Endymion1236/robothumanoide/apercu-bras/animation_bras.gif

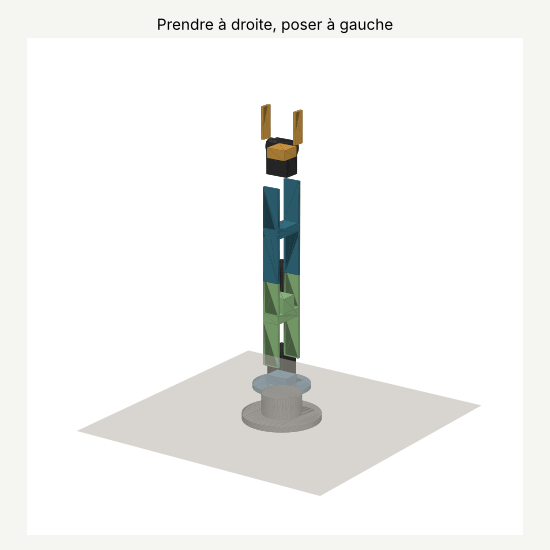
apercu-bras/animation_bras.gif
