Endymion1236/robothumanoide/apercu-bras/apercu_bras_complet.png

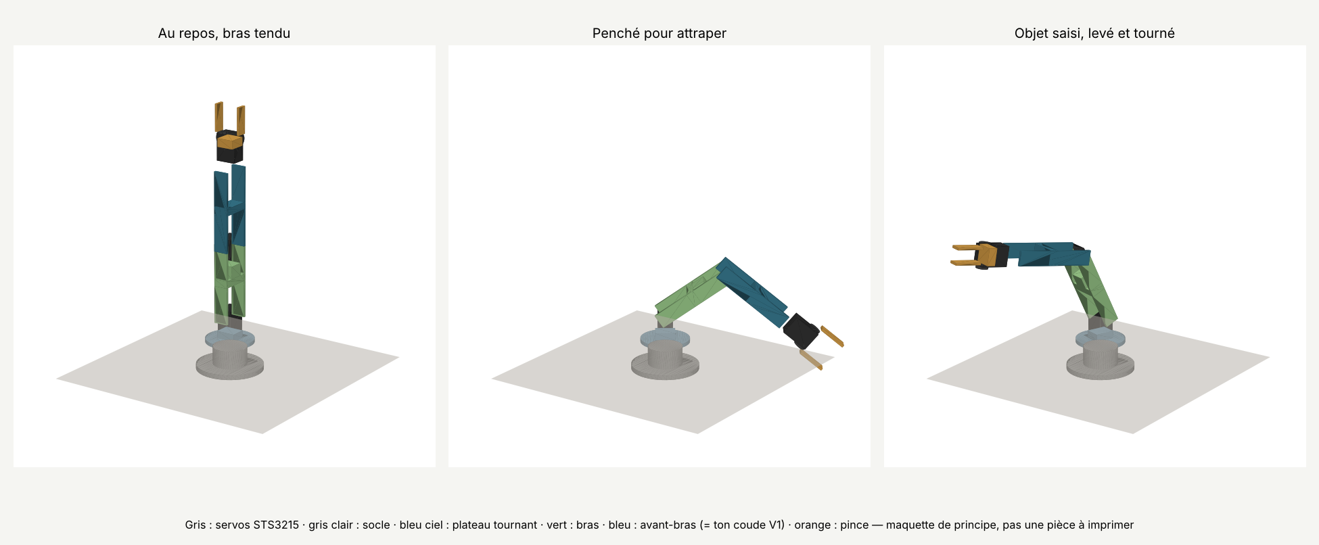
apercu-bras/apercu_bras_complet.png
