Endymion1236/robothumanoide/apercu-bras/etapes_suivantes.png

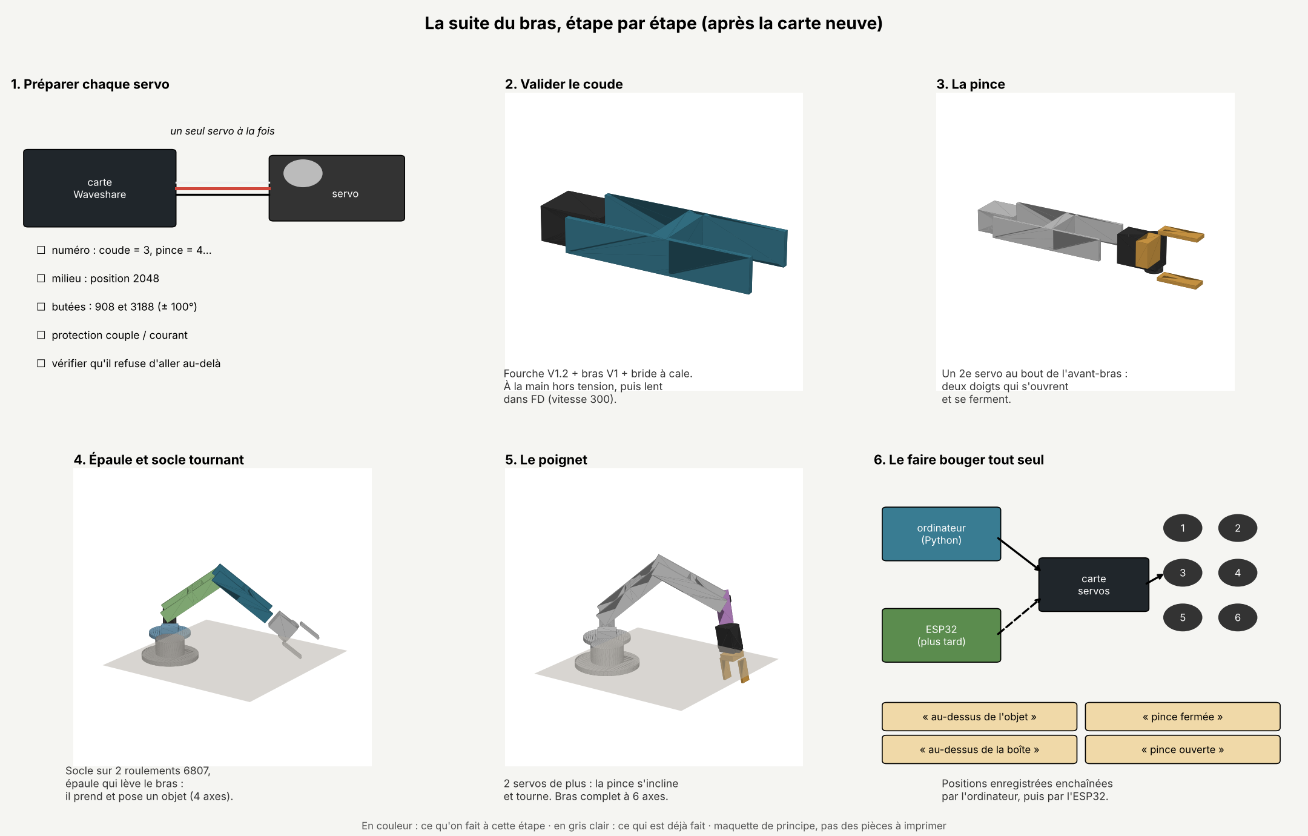
apercu-bras/etapes_suivantes.png
