Endymion1236/robothumanoide/apercu_V4.png

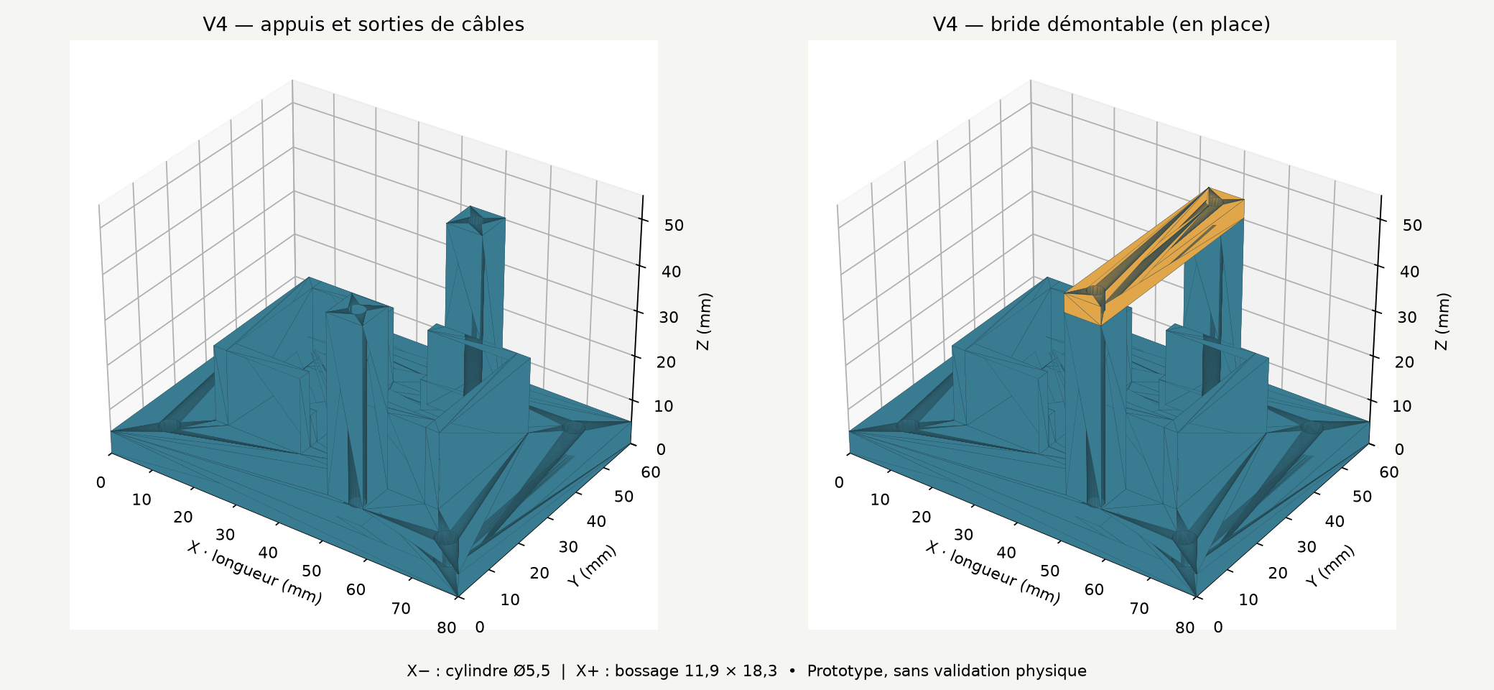
apercu_V4.png
