Endymion1236/robothumanoide/coude-sts3215/outputs/bras_v1/apercu_coude_sur_bras_V1.png

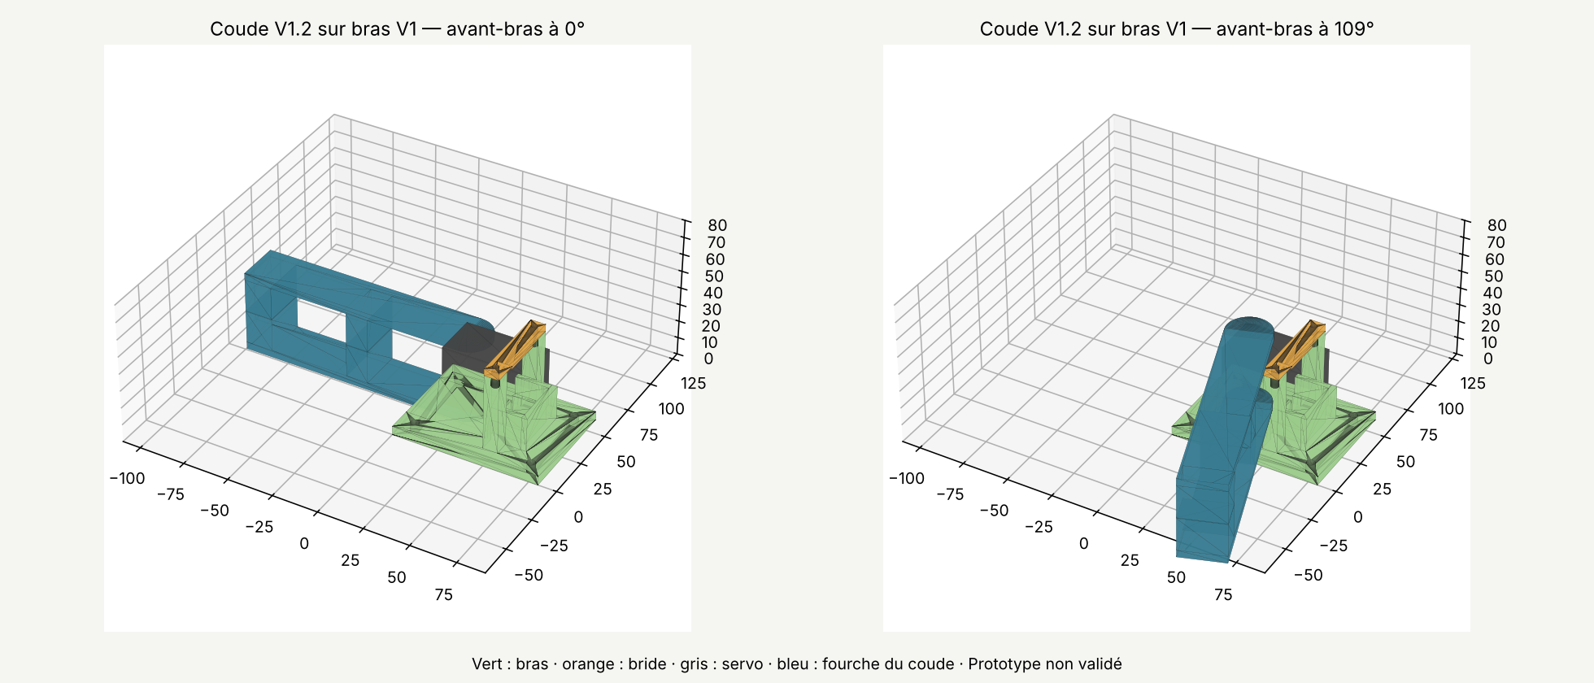
coude-sts3215/outputs/bras_v1/apercu_coude_sur_bras_V1.png
