Endymion1236/robothumanoide/coude-sts3215/outputs/coude_v1_2/apercu_coude_V1_2.png

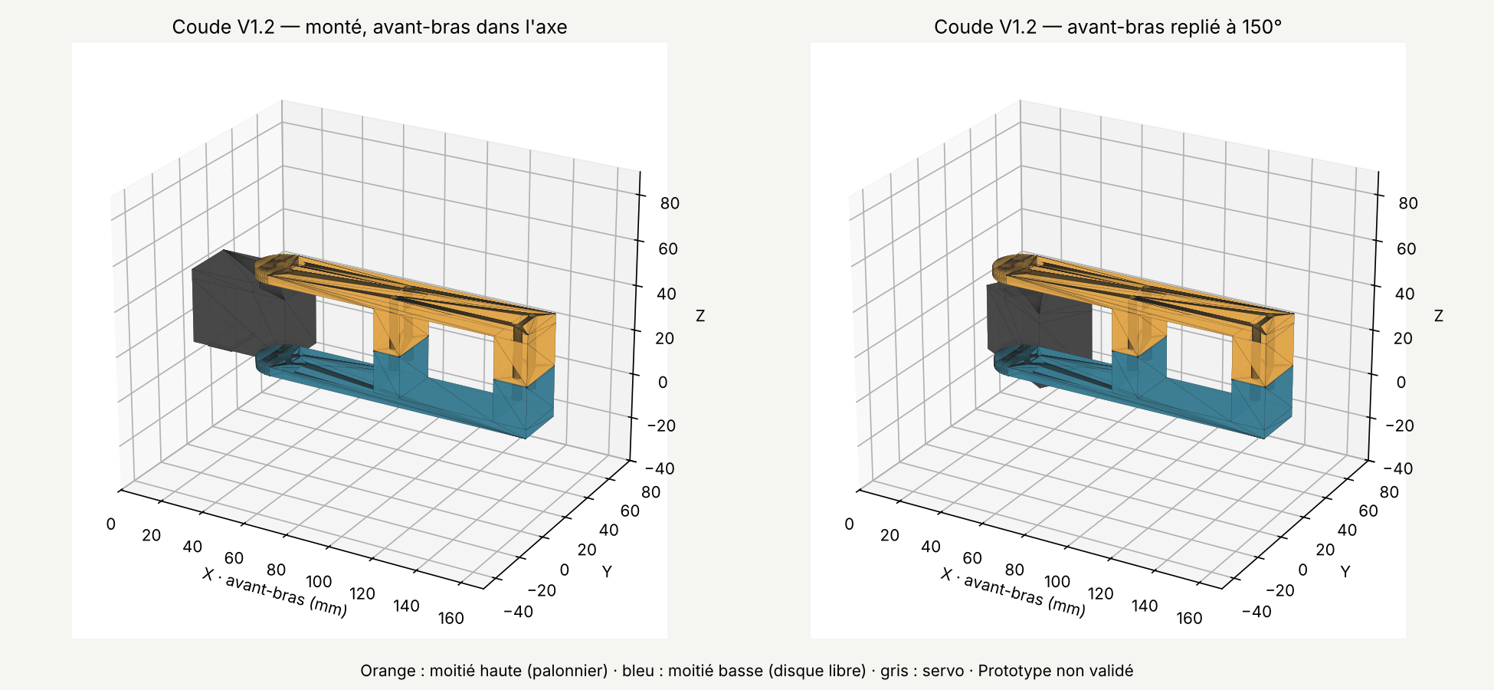
coude-sts3215/outputs/coude_v1_2/apercu_coude_V1_2.png
