Endymion1236/robothumanoide/pince/sortie/animation_pince.gif

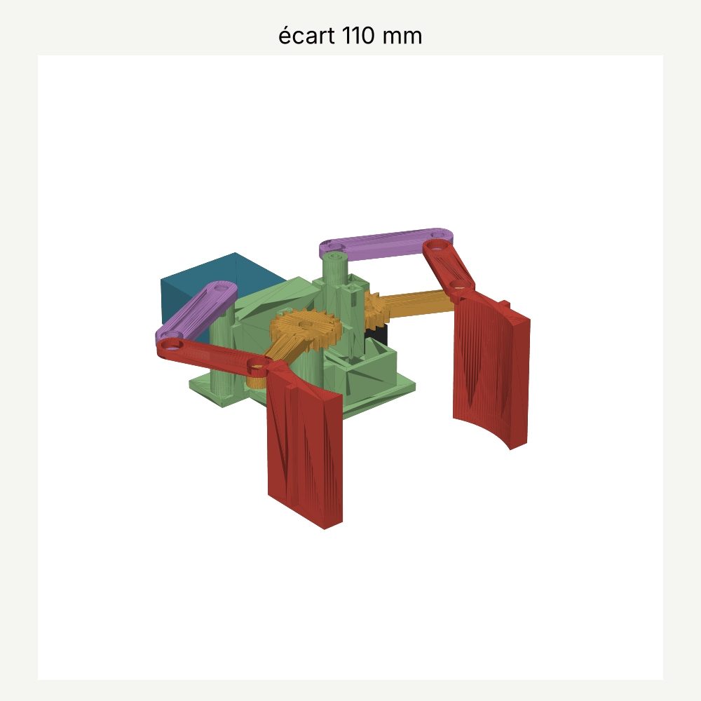
pince/sortie/animation_pince.gif
