Endymion1236/robothumanoide/pince/sortie/apercu_pince.png

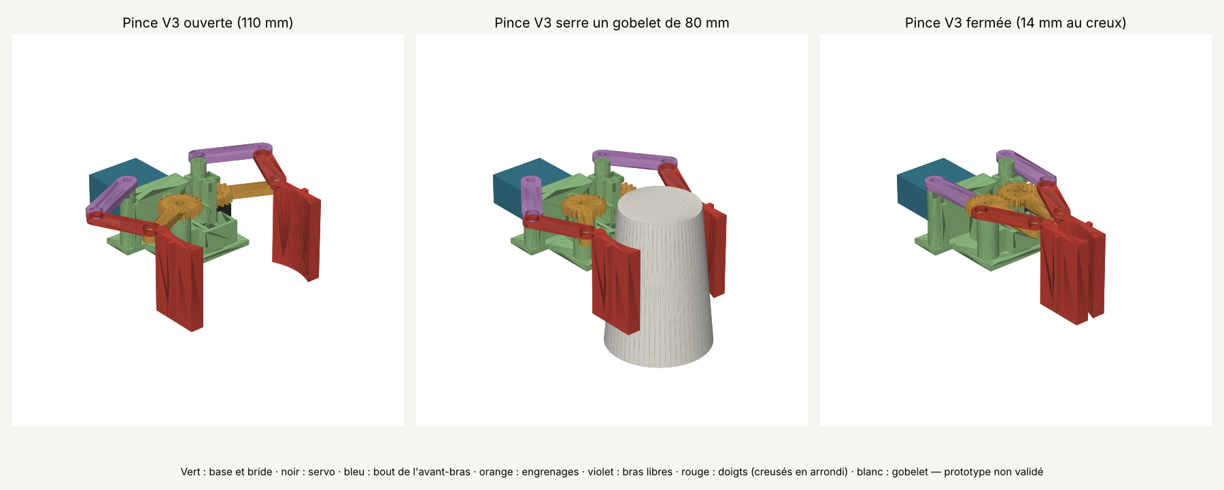
pince/sortie/apercu_pince.png
