Endymion1236/robothumanoide/pince/sortie/vue_dessus_montee.png

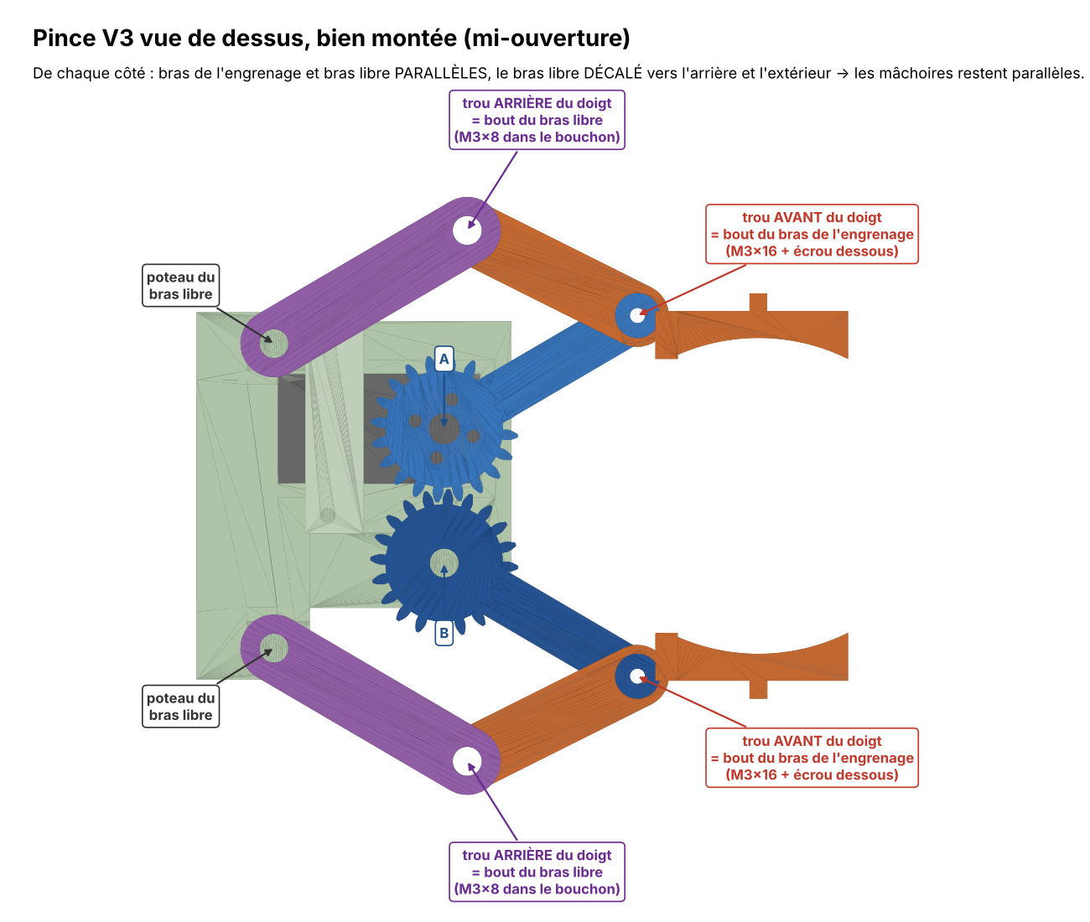
pince/sortie/vue_dessus_montee.png
