Endymion1236/robothumanoide/apercu-bras/maquette_bras_complet.stl

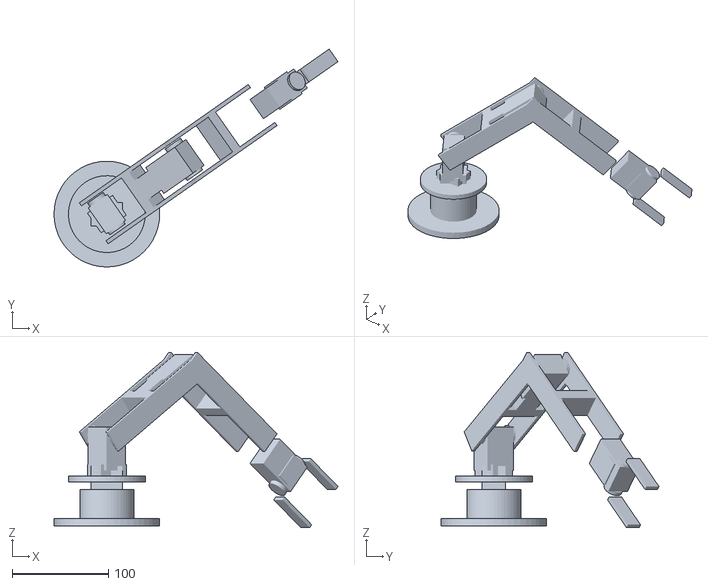
[picture p10: CAD file, 2026-11-07]
apercu-bras/maquette_bras_complet.stl
295.5 x 226.8 x 182.5
