Endymion1236/robothumanoide/berceau-sts3215/outputs/servo_cradle_v4_1/berceau_V4_1_TEST.stl

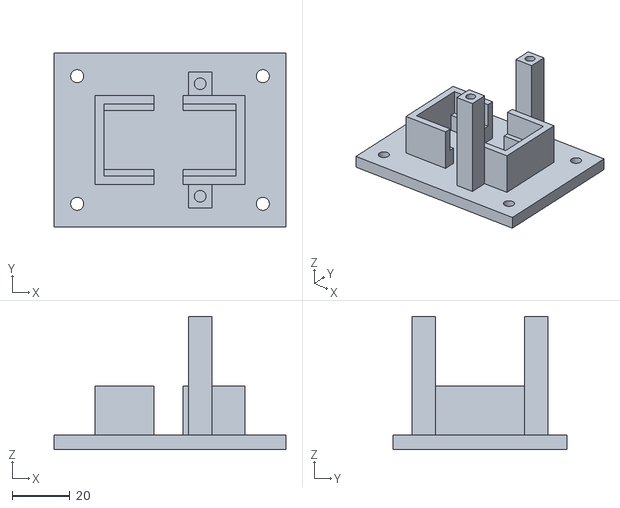
[picture p11: CAD file, 2026-11-07]
berceau-sts3215/outputs/servo_cradle_v4_1/berceau_V4_1_TEST.stl
80.0 x 60.0 x 45.9
