Endymion1236/robothumanoide/berceau_V4_TEST.stl

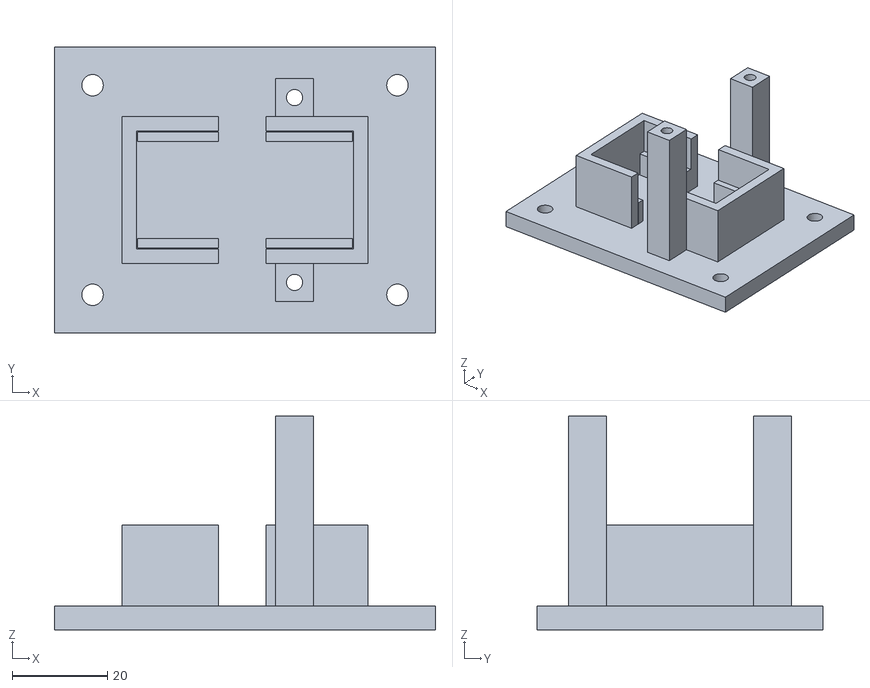
[picture p12: CAD file, 2026-11-07]
berceau_V4_TEST.stl
80.0 x 60.0 x 44.9
