Endymion1236/robothumanoide/coude-sts3215/outputs/bras_v1/bride_bras_V1_2_TEST.stl

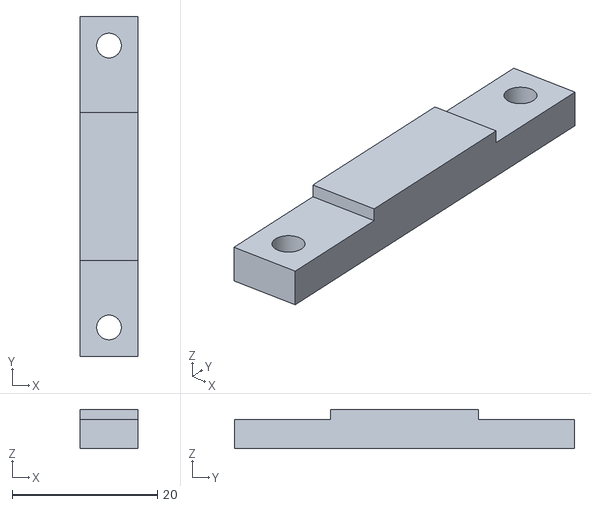
[picture p13: CAD file, 2026-11-08]
coude-sts3215/outputs/bras_v1/bride_bras_V1_2_TEST.stl
8.00 x 46.8 x 5.40
