Endymion1236/robothumanoide/coude-sts3215/outputs/coude_v1_2/fourche_basse_V1_2.stl

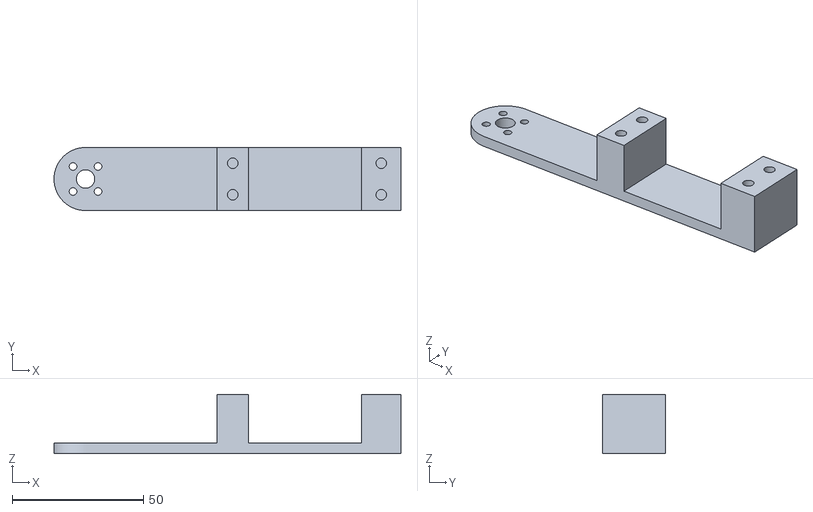
[picture p14: CAD file, 2026-11-08]
coude-sts3215/outputs/coude_v1_2/fourche_basse_V1_2.stl
132.0 x 24.0 x 22.5
