Endymion1236/robothumanoide/pince/sortie/pince_bras_libre_+Y.stl

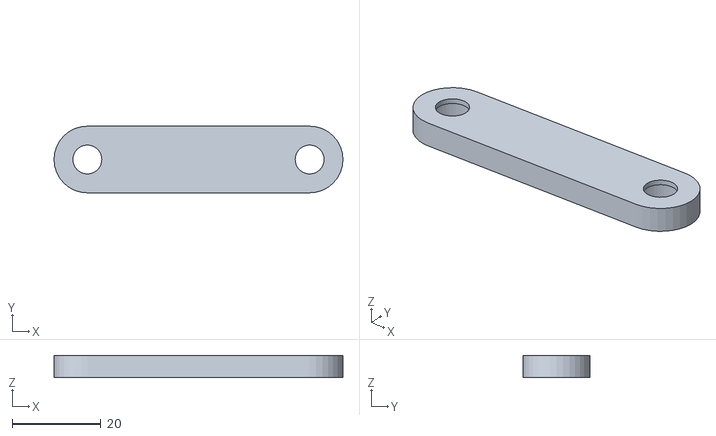
[picture p15: CAD file, 2026-11-14]
pince/sortie/pince_bras_libre_+Y.stl
65.0 x 15.0 x 5.00
