Endymion1236/robothumanoide/coude-sts3215/outputs/bras_v1/bras_V1_TEST.stl

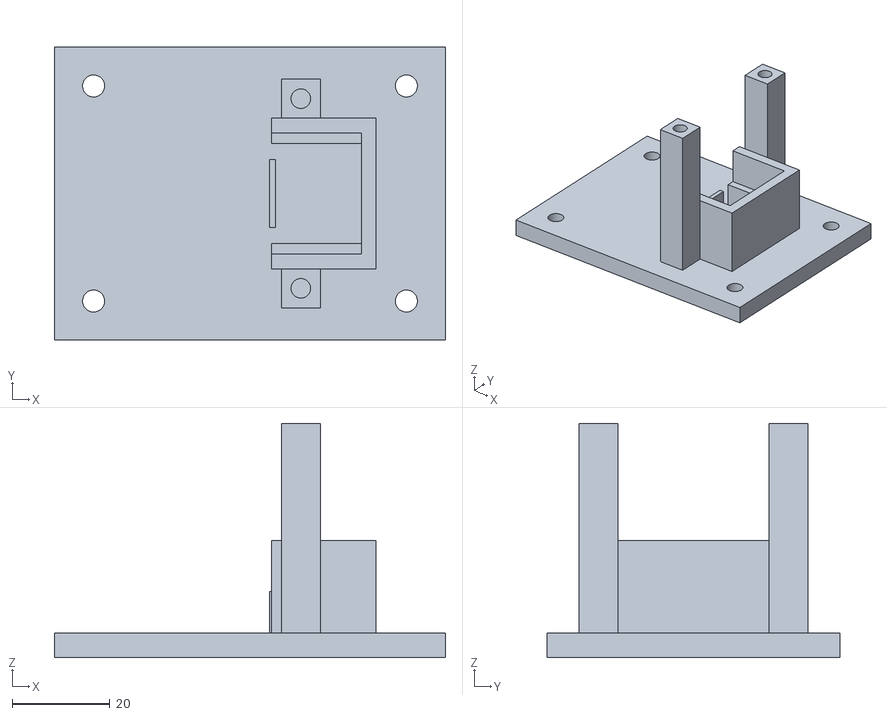
[picture p16: CAD file, 2026-11-07]
coude-sts3215/outputs/bras_v1/bras_V1_TEST.stl
80.0 x 60.0 x 47.9
