Endymion1236/robothumanoide/pince/sortie/pince_base.stl

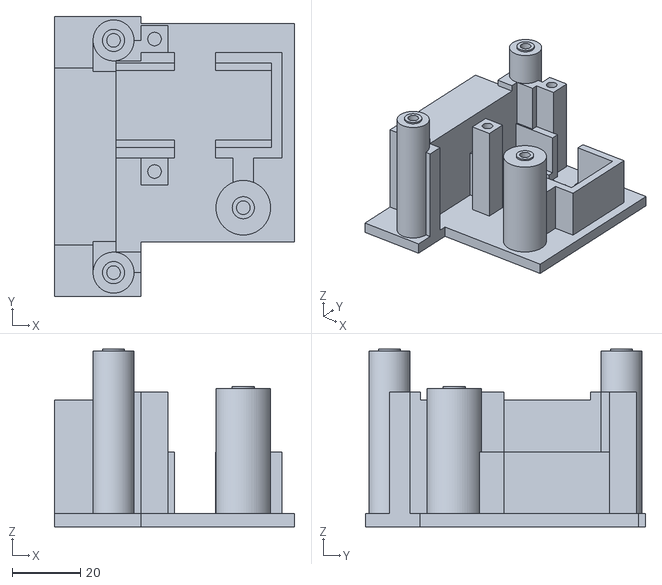
[picture p17: CAD file, 2026-11-14]
pince/sortie/pince_base.stl
70.3 x 82.0 x 52.1
