Endymion1236/robothumanoide/pince/sortie/pince_doigt_+Y.stl

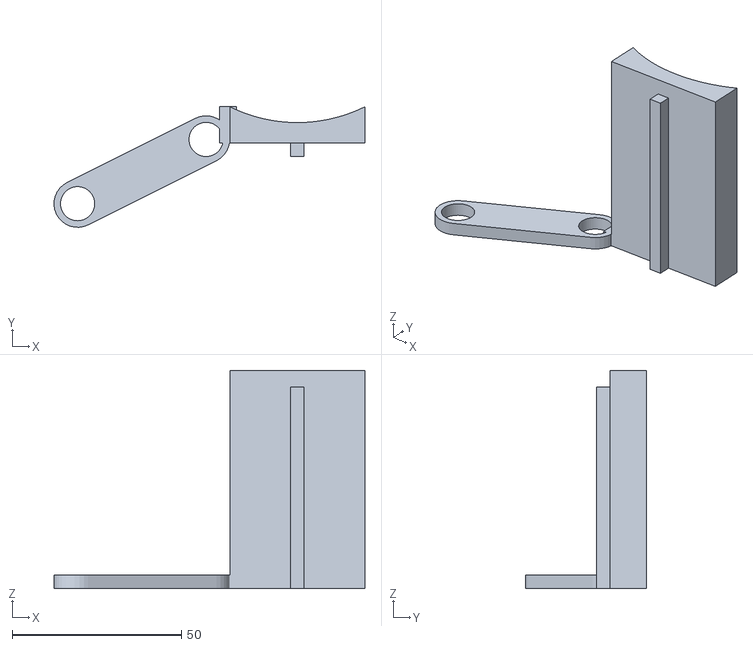
[picture p18: CAD file, 2026-11-14]
pince/sortie/pince_doigt_+Y.stl
92.0 x 35.7 x 64.6
