Endymion1236/robothumanoide/pince/sortie/pince_engrenage_A_vis6mm.stl

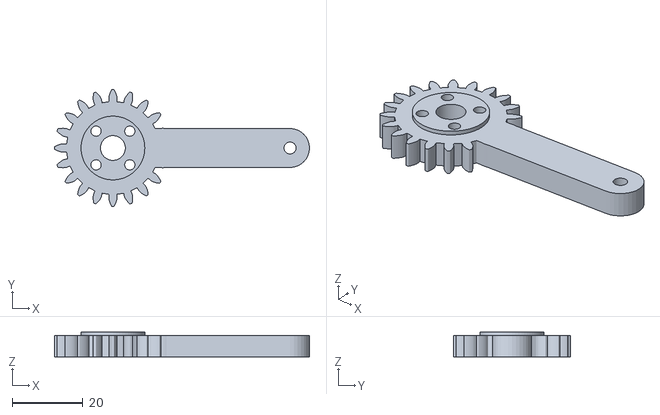
[picture p19: CAD file, 2026-11-14]
pince/sortie/pince_engrenage_A_vis6mm.stl
72.0 x 33.0 x 7.00
