Endymion1236/robothumanoide/pince/sortie/pince_engrenage_A.stl

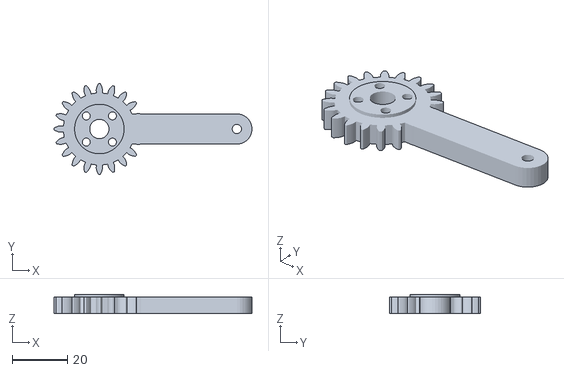
[picture p20: CAD file, 2026-11-14]
pince/sortie/pince_engrenage_A.stl
72.0 x 33.0 x 7.00
