Endymion1236/robothumanoide/pince/sortie/pince_engrenage_B.stl

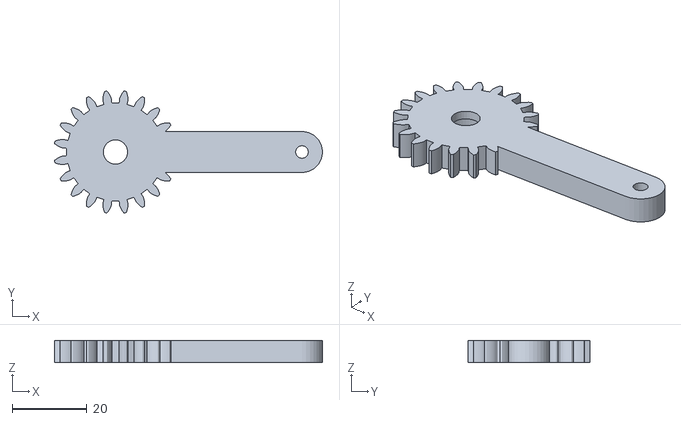
[picture p21: CAD file, 2026-11-14]
pince/sortie/pince_engrenage_B.stl
71.8 x 32.7 x 6.00
