Endymion1236/robothumanoide/pince/sortie/pince_doigt_+Y_insert.stl

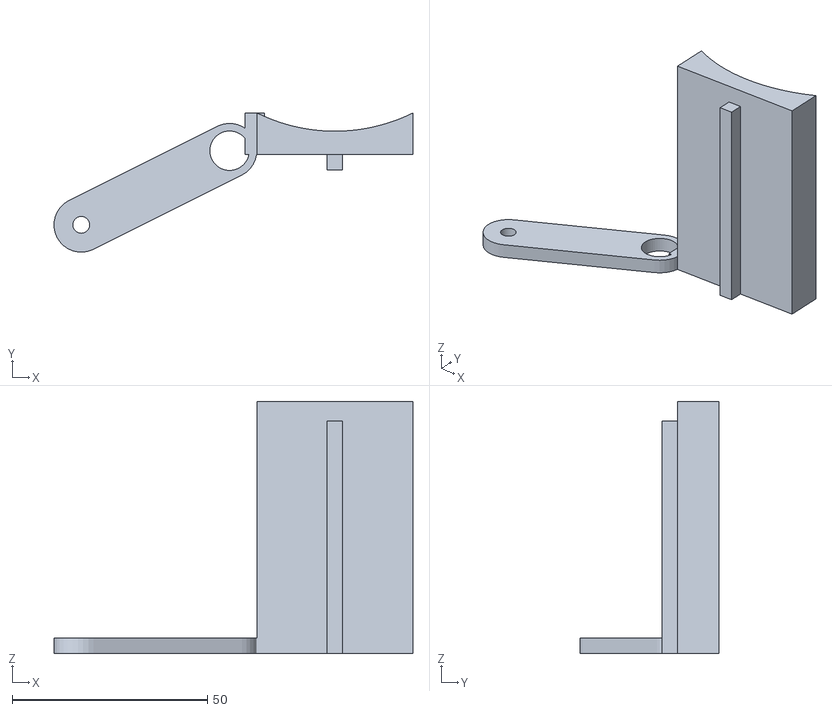
[picture p22: CAD file, 2026-11-14]
pince/sortie/pince_doigt_+Y_insert.stl
92.0 x 35.7 x 64.6
