Endymion1236/robothumanoide/pince/sortie/pince_bride.stl

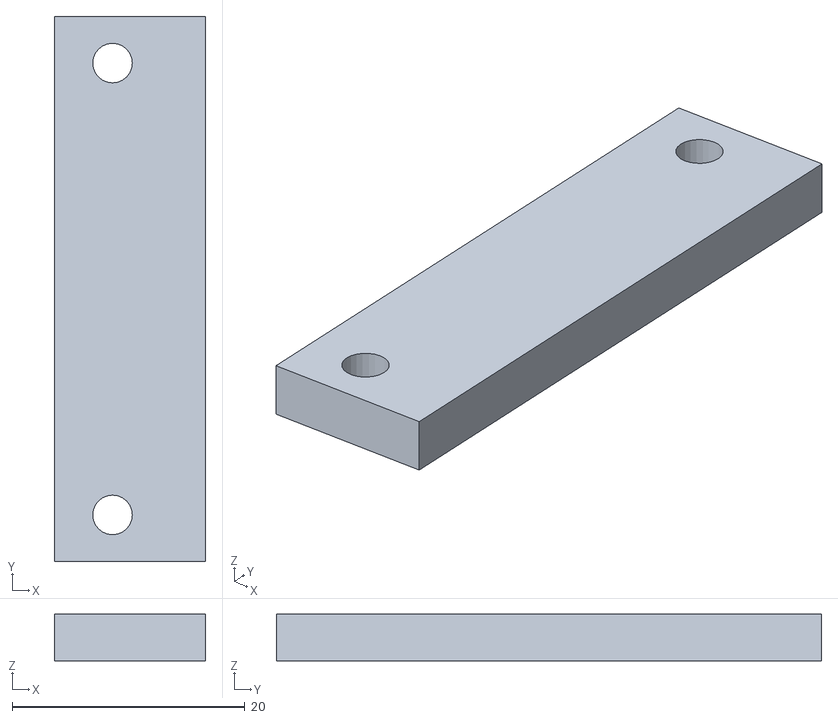
[picture p23: CAD file, 2026-11-14]
pince/sortie/pince_bride.stl
13.0 x 46.8 x 4.00
