Endymion1236/robothumanoide/pince/sortie/pince_bouchon_doigt_insert.stl

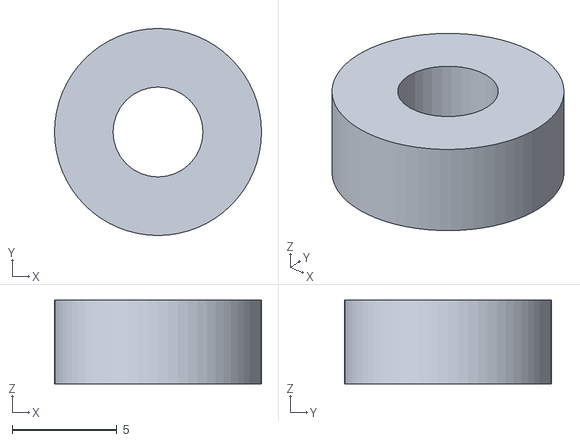
[picture p24: CAD file, 2026-11-14]
pince/sortie/pince_bouchon_doigt_insert.stl
9.90 x 9.90 x 4.00
