Endymion1236/robothumanoide/(list of files, cad)

Other CAD files:
coude-sts3215/outputs/coude_v1_2/fourche_haute_V1_2.stl
pince/sortie/pince_engrenage_A_vis5mm.stl
pince/sortie/pince_engrenage_A_vis4mm.stl
pince/sortie/pince_bouchon_doigt.stl
coude-sts3215/outputs/coude_v1/fourche_basse_V1.stl
coude-sts3215/outputs/coude_v1/fourche_haute_V1.stl
pince/sortie/pince_bras_libre_-Y.stl
pince/sortie/pince_doigt_-Y.stl
pince/sortie/pince_doigt_-Y_insert.stl
