Endymion1236/robothumanoide/pince/sortie/plan_montage_00.png

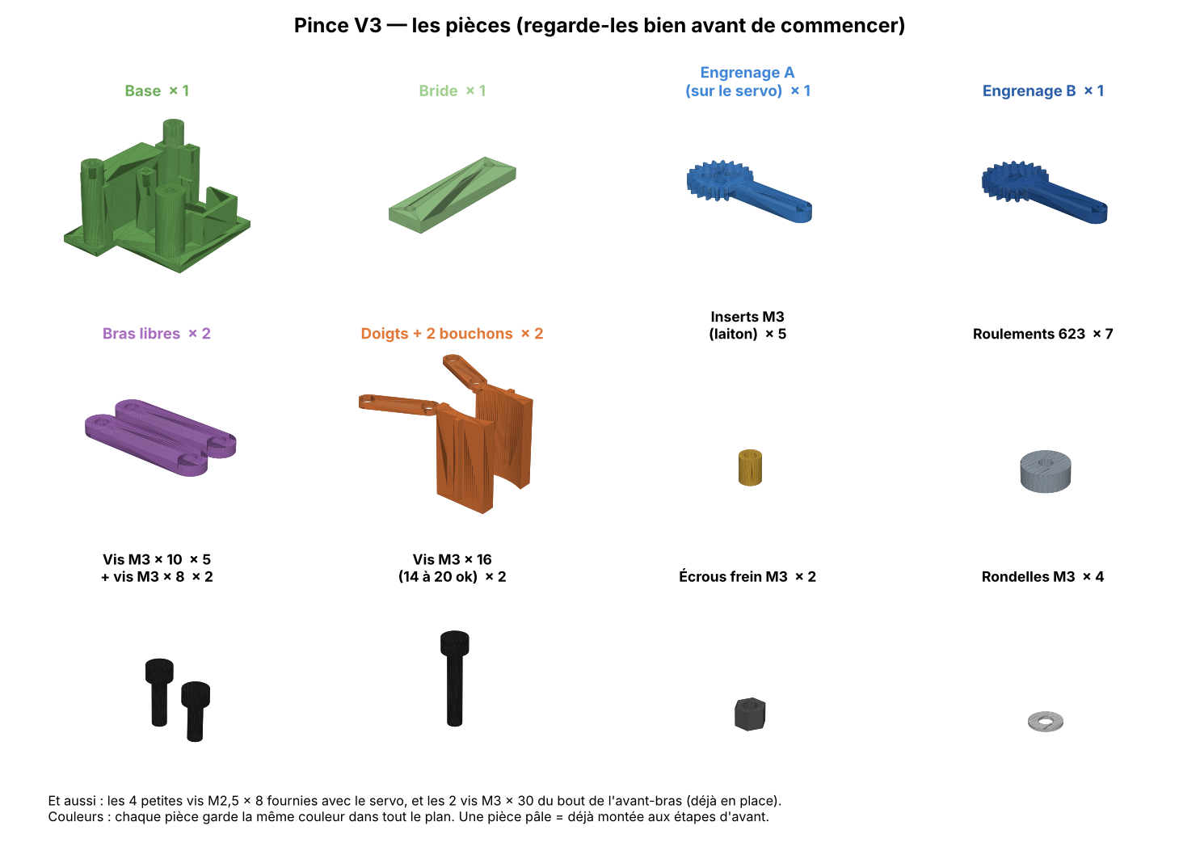
pince/sortie/plan_montage_00.png
