Endymion1236/robothumanoide/pince/sortie/plan_montage_01.png

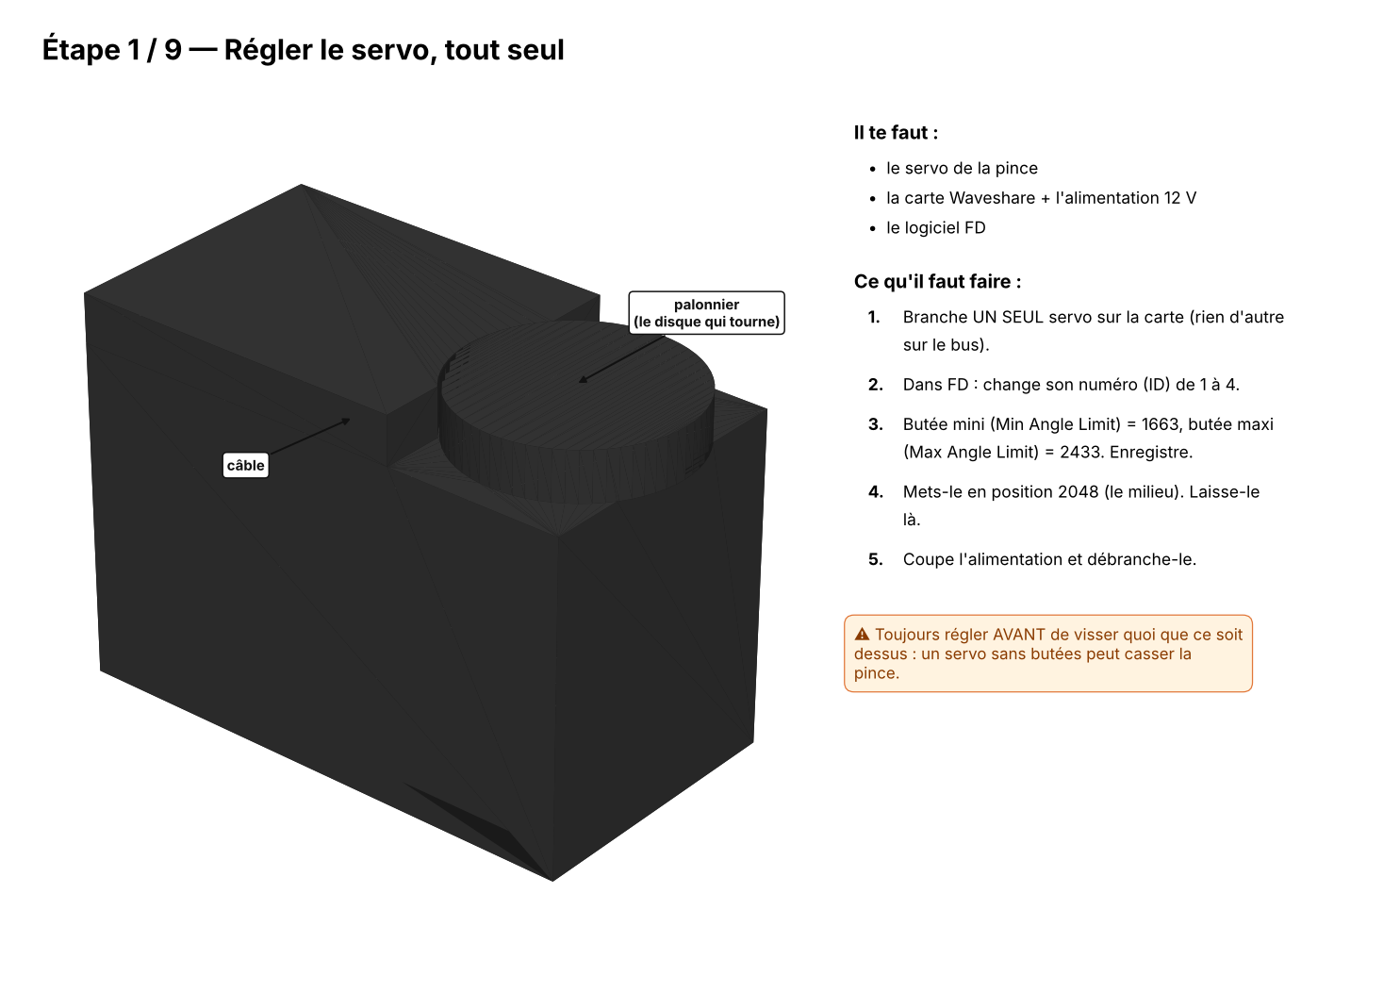
pince/sortie/plan_montage_01.png
