Endymion1236/robothumanoide/pince/sortie/plan_montage_02.png

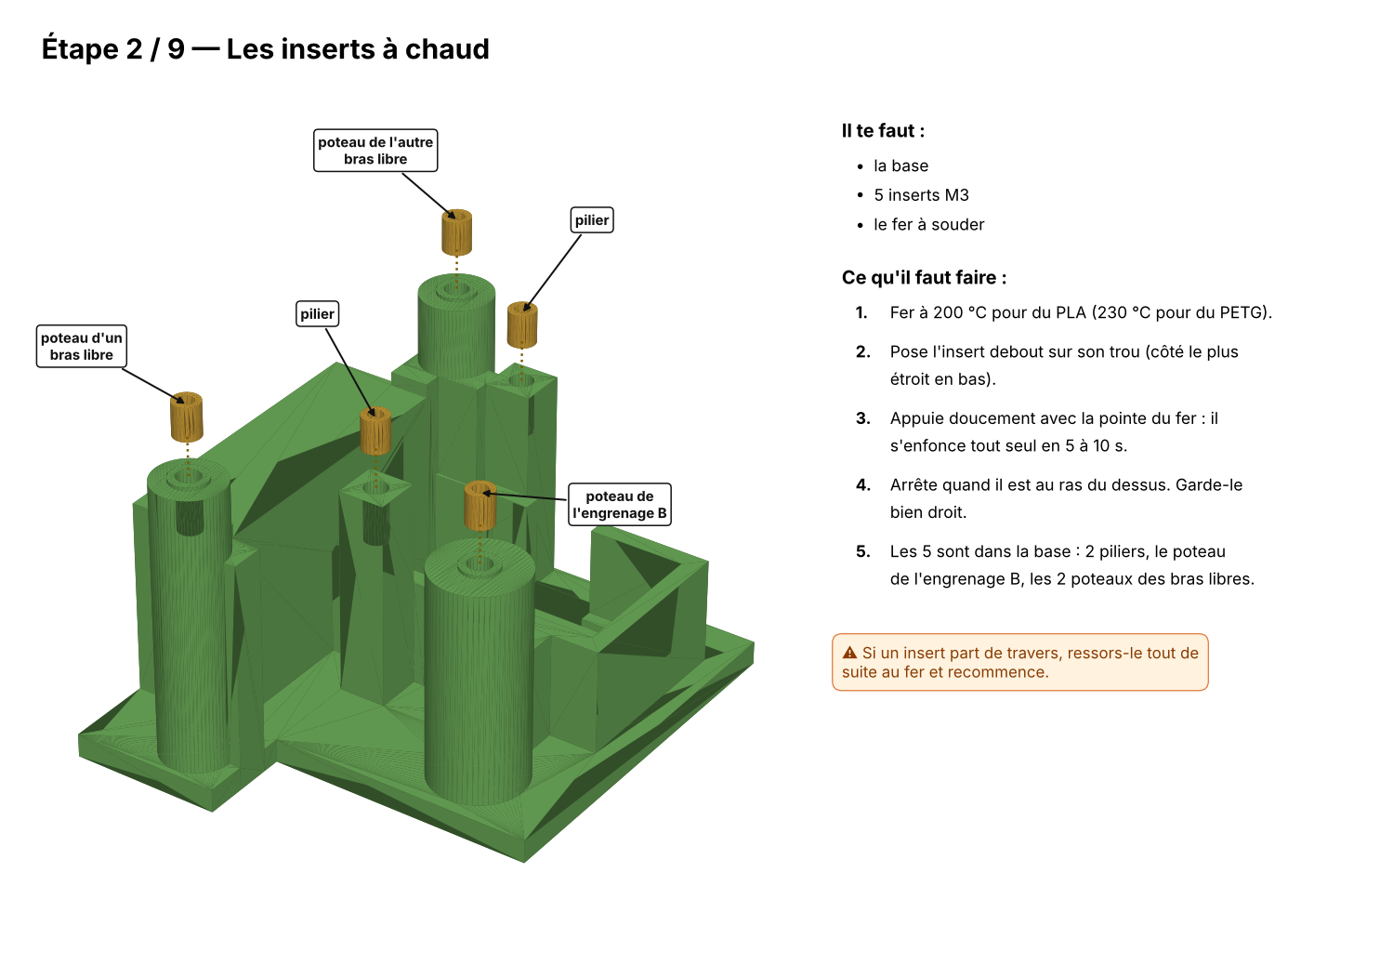
pince/sortie/plan_montage_02.png
