Endymion1236/robothumanoide/pince/sortie/plan_montage_03.png

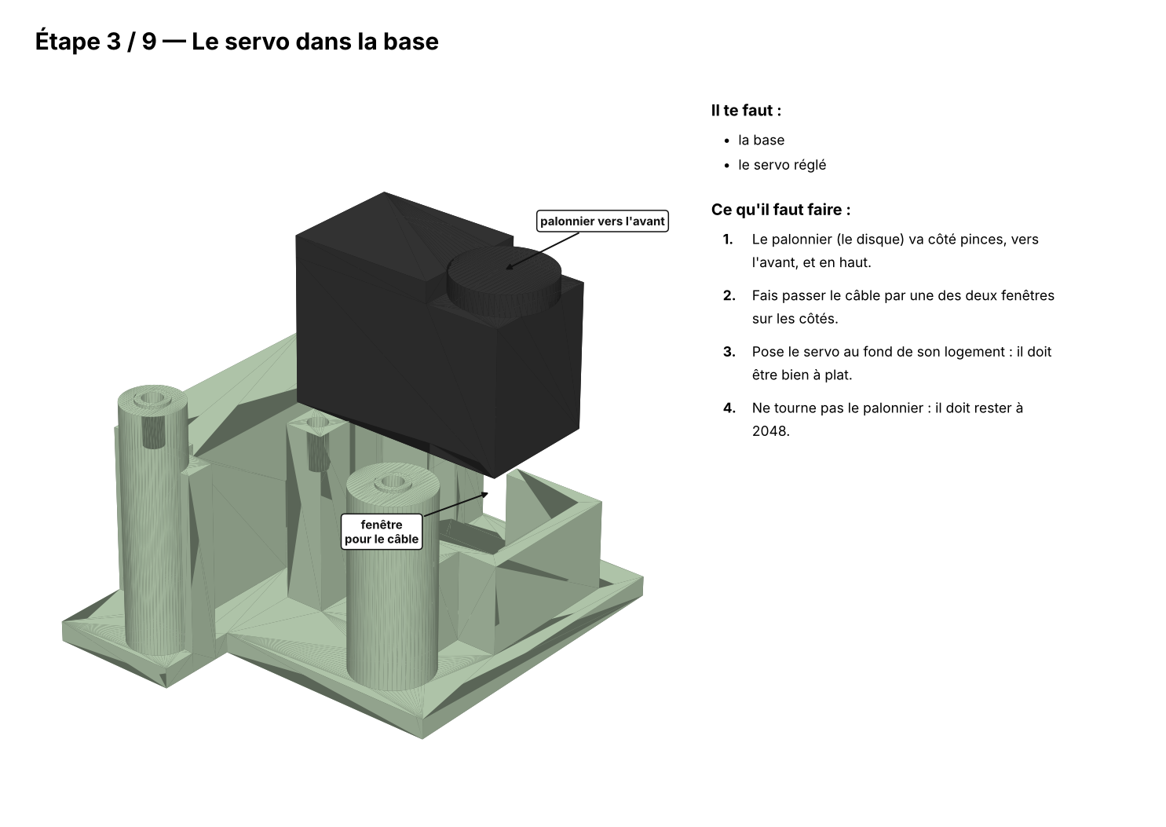
pince/sortie/plan_montage_03.png
