Endymion1236/robothumanoide/pince/sortie/plan_montage_04.png

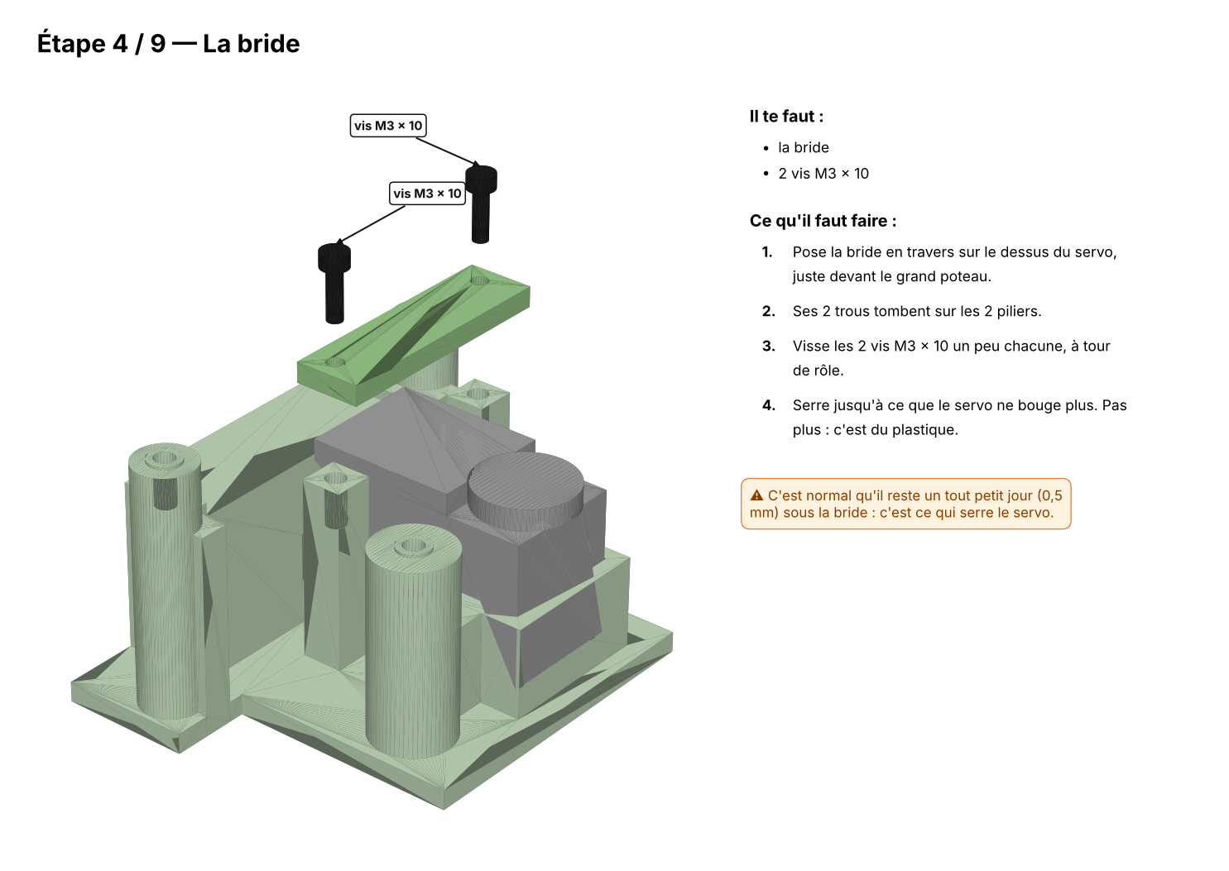
pince/sortie/plan_montage_04.png
