Endymion1236/robothumanoide/pince/sortie/plan_montage_05.png

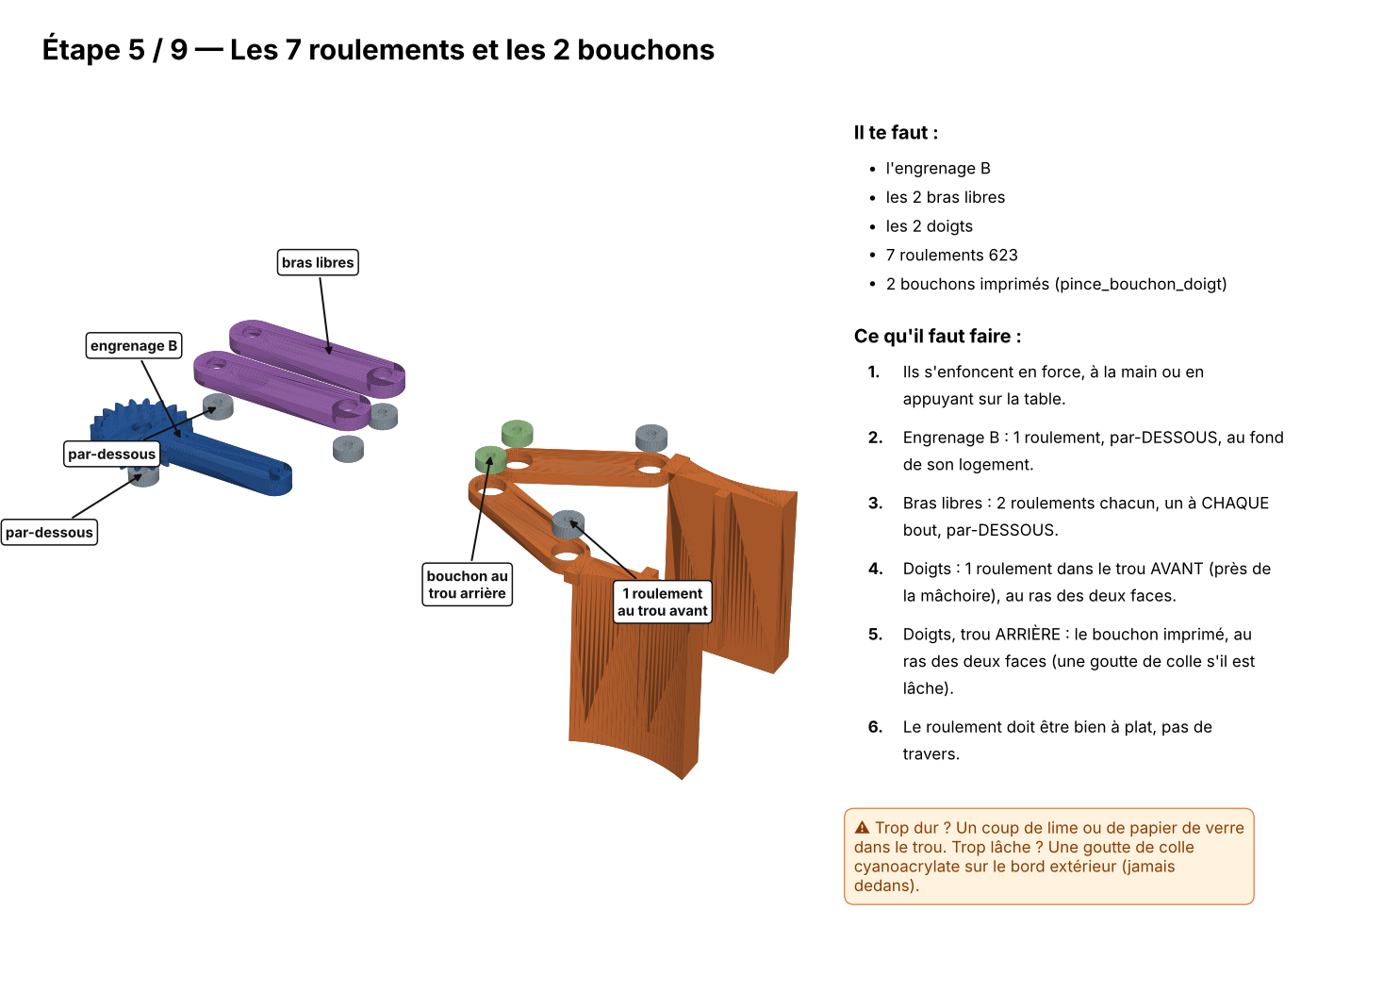
pince/sortie/plan_montage_05.png
