Endymion1236/robothumanoide/pince/sortie/plan_montage_06.png

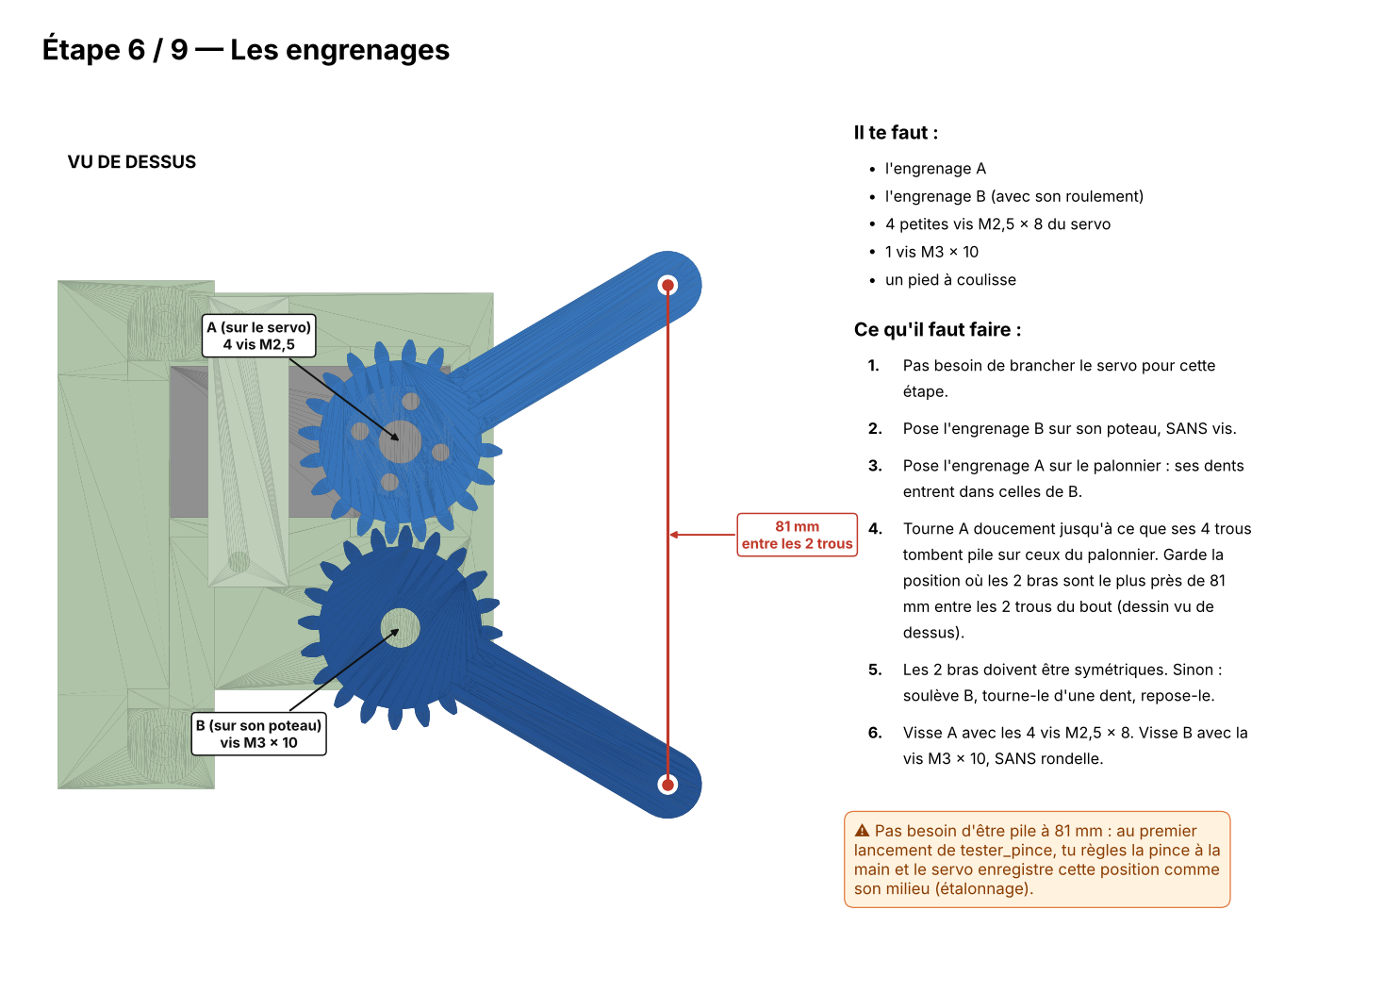
pince/sortie/plan_montage_06.png
