Endymion1236/robothumanoide/pince/sortie/plan_montage_07.png

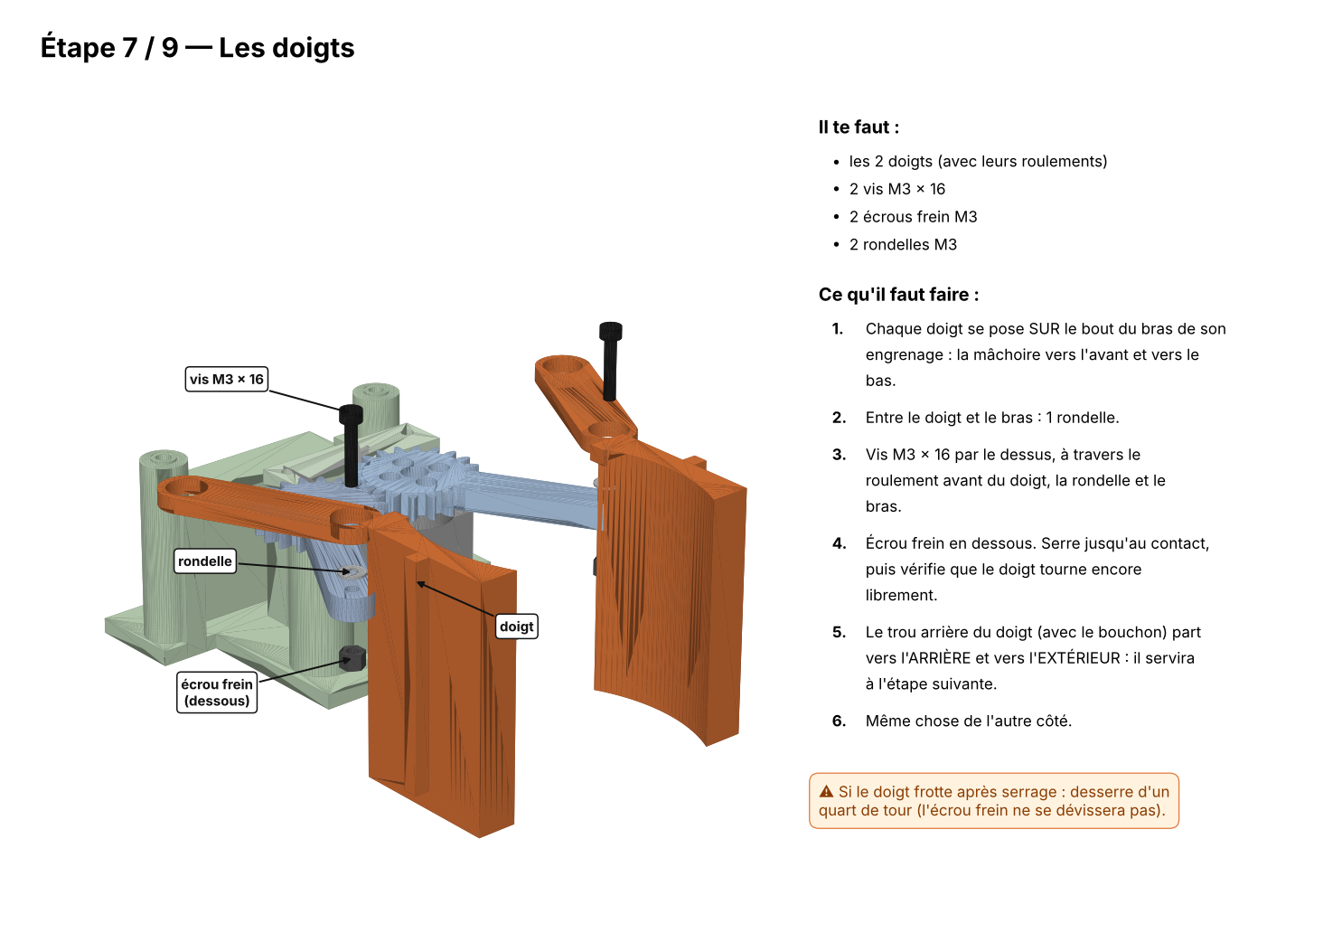
pince/sortie/plan_montage_07.png
