Endymion1236/robothumanoide/pince/sortie/plan_montage_08.png

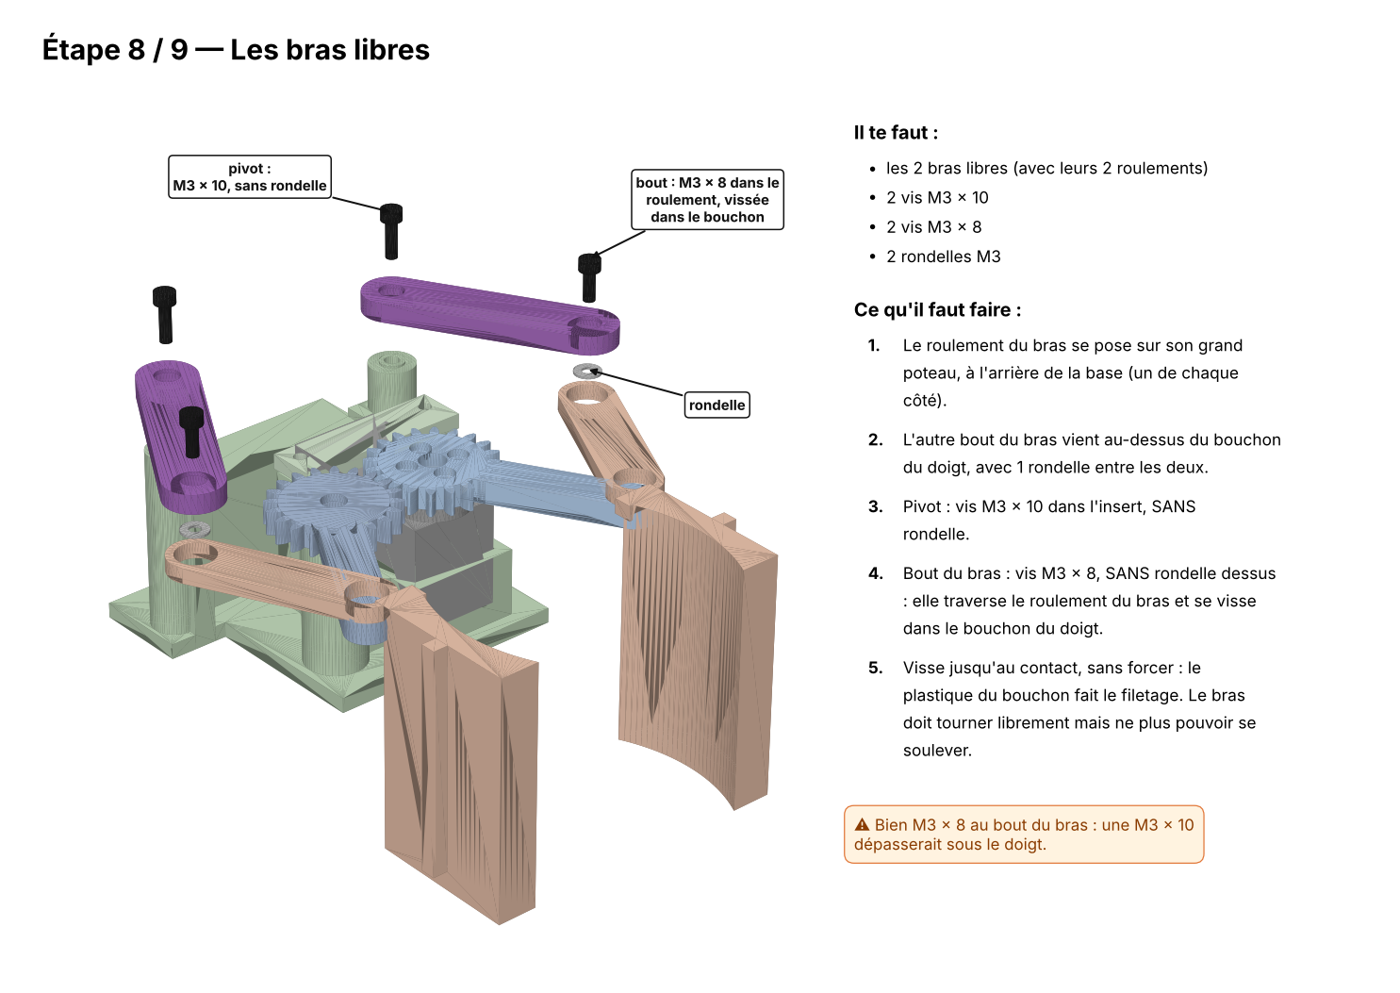
pince/sortie/plan_montage_08.png
