Endymion1236/robothumanoide/pince/sortie/plan_montage_09.png

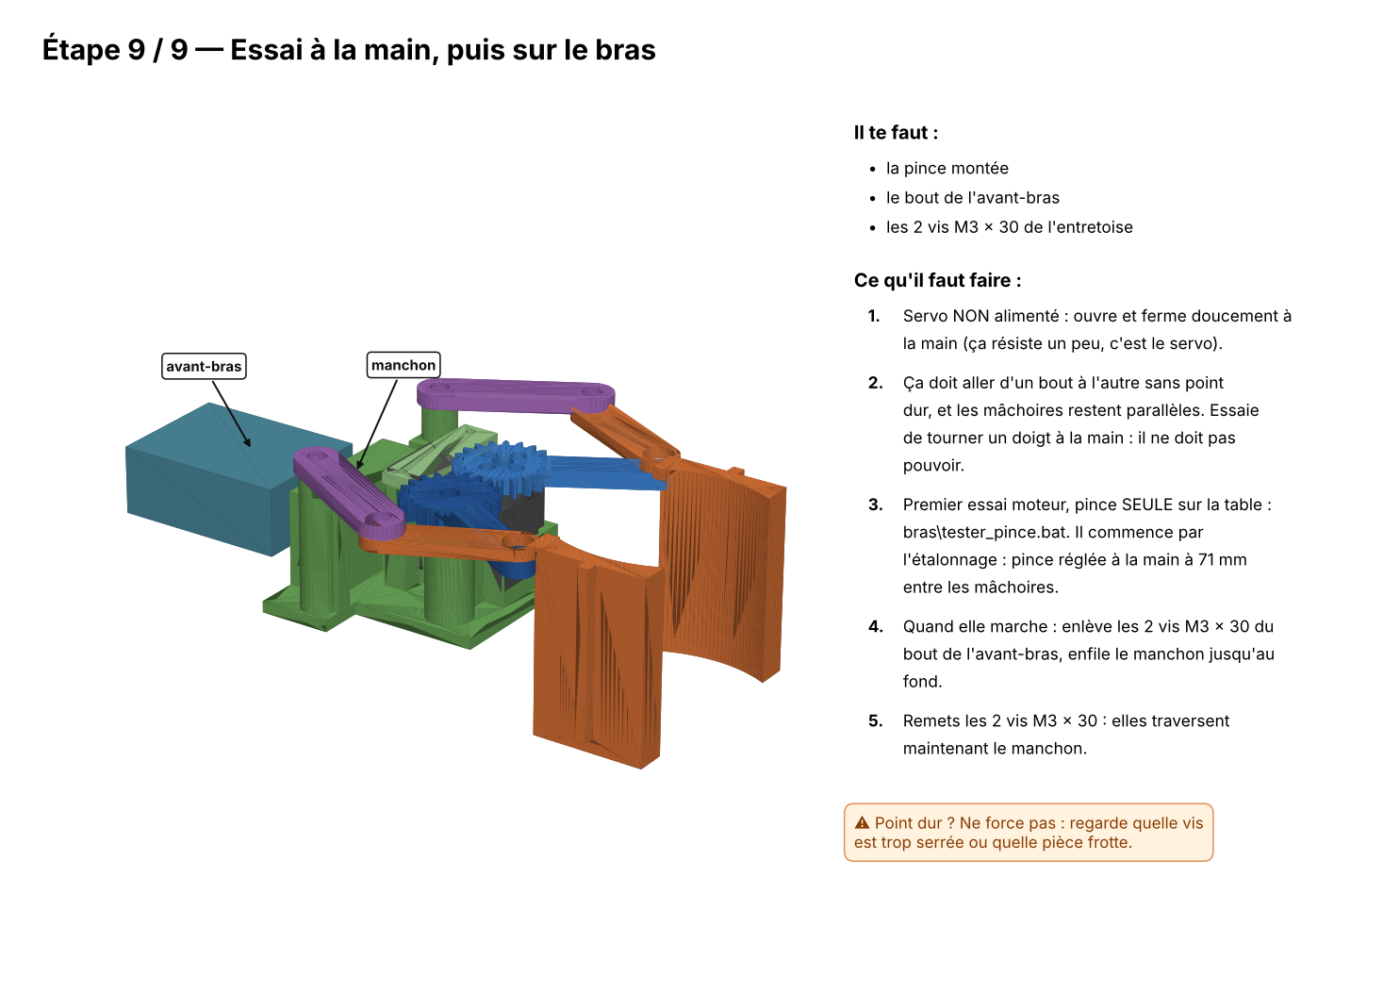
pince/sortie/plan_montage_09.png
