Endymion1236/robothumanoide/(commit log)

2026-11-07 Berceau STS3215 V4.1 : inserts M3, jeu de bride, appuis sans fente
    Contrôle de la V4 : la vis M3 × 50 dépassait d'environ 1,1 mm sous le socle,
    la bride était réglée au contact parfait (jeu 0) et une fente de 0,2 mm,
    impossible à imprimer, séparait les appuis des parois.
    V4.1 : inserts M3 posés à chaud en haut des colonnes (vis M3 × 10, plus
    d'écrou sous le socle), 1 mm de jeu sous la bride pour un patin, appuis
    collés aux parois et aux butées. La surface qui porte le servo ne change pas.
    STL construits hors de Fusion par verify_mesh.py ; le script Fusion V4.1
    n'a pas encore été exécuté.
    Claude-Session: https://claud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
    [berceau_V4_1_TEST.stl, bride_V4_1_TEST.stl]
2026-11-07 Feuille de route du projet : bras de table, coude STS3215, pince
    Le projet part sur un petit bras de table avec une pince au bout ; la main
    robotique viendra ensuite. Le README garde les étapes, leur état et les
    repères mesurés sur le servo.
    Claude-Session: https://claude.ai/code/session_011MQ11mbotgHHLgV4h86EGU
2026-11-07 Dossier driver-servo : fichiers pour piloter le STS3215 depuis le PC
    Programmes Python et bibliothèque Arduino/ESP32 de Waveshare, manuel du
    protocole avec la table des registres du STS3215, schéma de la carte Bus
    Servo Adapter (A). Le logiciel FD et le pilote CH343 ne se téléchargent
    pas depuis le serveur : liens et marche à suivre dans LISEZ-MOI.md.
    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
2026-11-07 Feuille de route : premier mouvement du STS3215 réussi
    Servo trouvé par le logiciel FD (COM3, 1000000 bauds), 12,3 V, 35 °C,
    état normal ; mouvement lent de 17° aller-retour.
    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
2026-11-07 Repères servo : étiquette 12 V et palonnier Ø19,7
    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
2026-11-07 Repères servo : cotes du palonnier et écart palonnier/cylindre à vérifier
    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
2026-11-07 Repères servo : palonnier aligné avec le cylindre (8,1 mm)
    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
2026-11-07 Repères servo : vis M2,5 et second disque du dessous
    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
2026-11-07 Repères servo : disque du dessous libre, 3 mm de dépassement
    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
2026-11-07 Coude STS3215 V1 : fourche d'avant-bras en deux moitiés
    Le bras de table a besoin d'un coude : l'avant-bras est tenu des deux
    côtés du servo, par le palonnier en haut et par le disque libre monté
    sur le cylindre du dessous (mesures du 07/11/2026 : écart 40,2 mm,
    cercle des trous 13,45, vis M2,5).
    Deux moitiés vissées chacune sur son disque, serrées l'une sur l'autre
    par deux entretoises (inserts M3) avec 0,4 mm de jeu de serrage.
    Avant-bras de 120 mm, paramétrable. Contrôle indépendant hors Fusion :
    pièces fermées, aucune collision au montage, rotation du servo sur un
    tour complet sans contact. Le script Fusion n'a pas encore été exécuté.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
    [fourche_basse_V1.stl, fourche_haute_V1.stl]
2026-11-07 Bras V1 : support du servo pour le coude, repris du berceau V4
    Le berceau V4 imprimé est validé à sec (le servo entre sans forcer, il
    est stable, les câbles passent), mais son fond plein empêche la moitié
    basse de la fourche du coude de passer sous le servo.
    Bras V1 : côté de l'axe entièrement dégagé, appuis relevés à 9 mm
    (2 mm sous la fourche), une nervure devant le bossage remplace la butée
    disparue, bride de la V4.1. Contrôle hors Fusion : pièces saines, aucune
    collision au montage ; coude monté, l'avant-bras tourne de -109° à
    +109° avant de toucher une colonne. Script Fusion non exécuté.
    Claude-Session: http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
    [bras_V1_TEST.stl, bride_bras_V1_TEST.stl]
2026-11-07 Maquette du futur bras de table à 4 servos
    Pour voir où mène le coude : socle tournant, épaule, coude et pince en
    STS3215, bras et avant-bras de 120 mm. Trois positions en image, une
    animation « prendre à droite, poser à gauche » et un STL à importer
    dans Fusion. Maquette de principe, pas des pièces à imprimer.
    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
    [maquette_bras_complet.stl]
2026-11-07 Feuille de route : matériel choisi (servos, alimentation, roulements du socle)
    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
2026-11-08 Coude V1.1 : écart entre les disques mesuré (36,4 au lieu de 40,2)
    Sur la fourche V1 imprimée, les plaques étaient pincées en V : 44,3 mm
    au palonnier, 48,3 au bout, blocs fermés. La V1 additionnait trois cotes
    (3 + 32,9 + 4,3 = 40,2) ; l'écart mesuré entre les deux disques est de
    36,4. La V1.1 prend la mesure directe et approfondit les trous d'insert
    à 9 mm pour que la vis M3 x 30 ne touche pas le fond.
    Contrôles hors Fusion refaits : pièces saines, aucune collision, tour
    complet libre ; sur le bras V1, rotation toujours de -109° à +109°.
    Reste à mesurer la hauteur du boîtier : la bride du bras en dépend.
    Claude-Sess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
    [fourche_basse_V1_1.stl, fourche_haute_V1_1.stl]
2026-11-08 Boîtier du STS3215 mesuré à 28,8 : bride V1.1 du bras avec un pied
    Les anciennes notes donnaient 32,9 de hauteur de boîtier ; mesuré : 28,8.
    C'était l'origine de l'erreur de 3,8 mm sur la fourche du coude
    (36,4 = 3,3 + 28,8 + 4,3). Sur le bras V1 déjà imprimé, la bride aurait
    flotté 5,1 mm au-dessus du servo : la bride V1.1 garde les mêmes trous
    et ajoute un pied de 4,1 mm, ce qui remet 1 mm pour le patin. Elle est
    exportée à l'envers pour s'imprimer sans support.
    Le modèle du coude V1.1 porte la hauteur mesurée (sa géométrie ne
    change pas). Contrôles hors Fusion refaits : aucune collision, rotation
    de -109° à +109°.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
    [bride_bras_V1_1_TEST.stl, bride_bras_V1_TEST.stl]
2026-11-08 Coude V1.2 : le dessus du servo est plus haut côté étiquette
    Nicolas a mesuré le dessus du STS3215 en plusieurs points : 28,8 côté
    palonnier, 33 à partir de 15,6 mm du bout (partie haute, côté étiquette).
    - Fourche V1.2 : la plaque haute de la V1.1 serait passée à 0,1 mm de la
    partie haute. Un patin de 0,9 mm sous la plaque appuie seul sur le
    palonnier, le reste de la plaque passe à 1 mm de la partie haute.
    Contrôles hors Fusion : aucune collision, tour complet libre, rotation
    de -109° à +109° sur le bras V1. Les STL de la V1.1 sont retirés.
    - Bras V1 : la bride d'origine (32,9) était juste, puisqu'elle appuie sur
    la partie haute (33). La bride V1.1 avec un pied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
    [bride_bras_V1_1_TEST.stl, bride_bras_V1_TEST.stl, fourche_basse_V1_1.stl, fourche_basse_V1_2.stl, fourche_haute_V1_1.stl, fourche_haute_V1_2.stl]
2026-11-08 Bras V1 : bride V1.2 avec une cale, le servo basculait vers l'axe
    Au montage, le servo penche vers l'axe : il n'est tenu que sur sa moitié
    arrière, la fourche fait levier, et les 0,9 mm de jeu sous la bride
    laissent le bout côté palonnier descendre d'environ 4 mm.
    La bride V1.2 porte une cale de 1,4 mm au-dessus du servo : 0,9 pour
    combler le jeu et 0,5 de serrage. Nicolas proposait 2 mm : la bride
    aurait été tordue de 1,1 mm au serrage, trop pour du PLA. Exportée à
    l'envers pour s'imprimer sans support ; rotation toujours de -109° à
    +109°.
    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
    [bride_bras_V1_2_TEST.stl, bride_bras_V1_TEST.stl]
2026-11-08 Feuille de route : incident du 08/11/2026 et règles de sécurité
    Odeur de brûlé au premier branchement avec la fourche montée ; la carte
    Waveshare n'apparaît plus sur l'ordinateur. Cause non établie (servo
    probablement bloqué contre une colonne, sans butées). Démarche de reprise
    et règles : butées et protections réglées avant tout montage,
    interrupteur sur le 12 V, jamais de branchement sous tension.
    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
2026-11-09 Feuille de route illustrée : les 6 étapes après la carte neuve
    Une image : préparer chaque servo seul (ID, milieu, butées, protection),
    valider le coude, la pince, épaule et socle tournant, le poignet, puis
    le pilotage par l'ordinateur et l'ESP32. Maquette de principe.
    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
2026-11-09 Feuille de route : vision d'ensemble, deux bras, une tête, voix et vision
    Objectif à terme décidé par Nicolas : deux bras à 6 axes et une tête,
    avec reconnaissance vocale, IA qui répond et reconnaissance d'objets.
    Matériel, difficulté de chaque partie, choix du « cerveau » (ordinateur,
    puis Raspberry Pi 5 ou Jetson ; l'ESP32 pour les petites tâches), piste
    LeRobot pour attraper un objet vu, et ordre des étapes.
    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
2026-11-10 Feuille de route : roulements pour tout le projet en une commande
    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
2026-11-10 Feuille de route : roulements commandés (8 × 6807-2RS, 10 × 623ZZ)
    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
2026-11-11 Tête du robot, étape 1 : reconnaître les objets avec la webcam
    Premier pas de la tête, sur l'ordinateur et sans moteur : vision.py filme
    avec la webcam, encadre les objets reconnus et les nomme en français
    (modèle YOLO11n, 80 sortes d'objets, téléchargé au premier lancement).
    Fichiers installer.bat et lancer_vision.bat pour Windows, mode d'emploi
    dans tete/LISEZ-MOI.md.
    Testé ici sur une photo d'exemple (bus et passants reconnus) ; pas
    encore essayé avec une vraie webcam.
    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
2026-11-11 Tête : chercher sa propre liste d'objets, et brancher une webcam USB
    Essai sur le PC de Nicolas : un rouleau de scotch reconnu comme un
    frisbee, un tube de colle comme un téléphone. Le premier modèle ne
    connaît que 80 objets et range le reste dans le plus proche.
    - lancer_objets.bat : modèle YOLO-World, qui cherche les objets d'une
    liste modifiable (objets.txt, « nom français = nom anglais »).
    - lister_cameras.bat : affiche les numéros des webcams branchées ;
    --camera écrit dans les lanceurs pour passer à une webcam USB.
    - Le composant CLIP s'installe depuis une archive zip, sans git.
    Testé ici sur une photo (lunettes de soleil, veste, chaussures trouvées
    avec une liste)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
2026-11-11 Tête, étape 2 : entendre (reconnaissance vocale en français)
    ecouter.py écoute le micro en continu, mesure le bruit de fond, découpe
    chaque phrase au silence et l'écrit en clair. Reconnaissance Whisper
    (faster-whisper, modèle « small »), sur le PC, gratuite et hors ligne une
    fois le modèle téléchargé. Lanceurs lancer_ecoute.bat et lister_micros.bat ;
    les fichiers de clés d'API sont exclus de GitHub.
    Testé ici sur un enregistrement de voix française : phrase comprise mot
    pour mot, deux phrases séparées par un silence découpées en deux. Pas
    encore essayé avec un vrai micro.
    Claude-Session: https://claude.ai/code/ses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
2026-11-11 Tête : masquer les avertissements sans gravité du téléchargement de Whisper
    Sous Windows, le premier lancement affichait des avertissements sur les
    liens symboliques et l'absence de jeton Hugging Face : sans conséquence,
    mais inquiétants. Le lanceur les masque.
    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
2026-11-11 Tête : écoute validée sur le PC de Nicolas
    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
2026-11-11 Tête, étape 3 : conversation à voix haute avec Câlin
    parler.py enchaîne écoute (Whisper), réponse (Claude) et voix
    (ElevenLabs, ou la voix gratuite de Windows). Le robot s'appelle Câlin,
    comme la borne d'accueil du club, avec le même caractère, en vue d'une
    fusion. Pendant qu'il parle, le micro est mis en pause pour qu'il ne
    s'entende pas ; les phrases fantômes de Whisper sont filtrées.
    Les clés sont lues hors du projet (C:\projet robot\..., puis le dossier
    personnel) : jamais sur GitHub. Testé ici sans clés (lecture des clés,
    filtre, message clair sur une clé fausse) ; la vraie réponse de Claude
    et la voix ElevenLabs restent à essayer sur le PC.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
2026-11-11 Tête : tout câblé (voir, entendre, répondre) et conversation plus rapide
    Nicolas a parlé avec Câlin : ça marche, mais c'est un peu lent.
    - robot.py / lancer_robot.bat : la caméra tourne en continu dans un fil
    à part ; à chaque phrase, Câlin reçoit la liste de ce qu'elle détecte,
    et la photo quand la question porte sur ce qu'il voit (Claude reconnaît
    bien plus d'objets que le petit modèle de détection).
    - Plus rapide : réponse en flux, dite phrase par phrase pendant que la
    suite s'écrit ; voix ElevenLabs eleven_flash_v2_5 jouée dès les
    premiers octets ; fin de phrase à 0,6 s de silence ; --ia sonnet pour
    essayer l'IA de la borne ; temps de chaque étape affic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
2026-11-11 Tête : mémoire d'une conversation à l'autre et reconnaissance des visages
    Nicolas veut que Câlin se souvienne et reconnaisse les visages.
    - memoire.py : faits courts, datés, par personne, relus au démarrage.
    - visages.py : OpenCV YuNet + SFace sur le PC ; empreintes (pas de
    photos), une par personne, effaçables.
    - Claude déclenche lui-même 4 outils : retenir, oublier_souvenirs,
    apprendre_visage, oublier_visage. Pas de second appel à l'IA : la
    phrase à dire part tout de suite, une note reste dans l'historique.
    - RGPD : un visage n'est appris qu'à la demande de la personne elle-même,
    jamais pour un enfant ; ni santé, ni adresse, ni argent en mémoire ;
    tout est rangé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
2026-11-11 Tête : webcam USB et Claude Sonnet 5.5 par défaut
    Demande de Nicolas : la webcam n° 1 (USB) dans les réglages, et Sonnet
    pour répondre plus vite. Les lanceurs et les programmes partent
    désormais de --camera 1 et --ia sonnet (l'IA de la borne) ; --camera 0
    et --ia opus restent disponibles. Un ZIP retéléchargé garde ces réglages.
    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
2026-11-11 Bras : piloter les servos depuis le PC, et premier essai sûr du coude
    Pour relier Câlin aux servos, Nicolas veut d'abord tester le bras.
    - bras/servos.py : dialogue avec les STS3215 par la carte Waveshare
    (bibliothèque scservo_sdk de Feetech/Waveshare), avec les leçons de
    l'incident du 08/11 : mouvement refusé sans butées réglées dans le
    servo ou hors de ces butées, vitesse lente, force coupée si le servo
    chauffe (55 °C), force (70 % pendant 0,5 s) ou n'arrive pas (8 s).
    - bras/test_coude.py et tester_coude.bat : trouve la carte et le servo,
    propose de régler les butées du coude (908-3188, ± 100°), menu centre /
    ± 30° / ± 90° / libre, force coupée en quittant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
2026-11-11 Tête : voix plus naturelle et sans coupures
    Nicolas trouve la voix hachée, et le modèle de voix rapide pas bon.
    - Modèle ElevenLabs eleven_multilingual_v2 par défaut (le plus naturel) ;
    --voix-rapide pour revenir à eleven_flash_v2_5.
    - Son joué après 0,8 s de réserve : un ralentissement d'internet ne
    fait plus de trous.
    - 1re phrase seule, puis les suivantes regroupées en un envoi, avec le
    texte déjà dit comme contexte : moins de coupures, intonation continue.
    - La caméra suspend la détection pendant que Câlin parle.
    Regroupement et pause de la caméra testés avec une fausse voix ; le son
    réel reste à écouter sur le PC.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
2026-11-11 Tête : voix ElevenLabs v4
    Nicolas demande la v4 d'ElevenLabs. Modèle eleven_v4 par défaut,
    eleven_v4_turbo avec --voix-rapide (identifiants lus dans la
    bibliothèque elevenlabs 2.77). La documentation d'ElevenLabs n'étant
    pas joignable d'ici, on ne sait pas si la v4 accepte le contexte
    d'intonation (previous_text) et la langue : en cas de refus 400/422, le
    programme le signale une fois et continue sans. Testé avec un faux
    ElevenLabs ; le vrai son reste à écouter sur le PC.
    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
2026-11-11 Tête : transcription ElevenLabs Scribe, et Whisper plus rapide
    Nicolas trouve encore long le temps entre la fin de sa phrase et le
    texte compris.
    - Par défaut, transcription ElevenLabs Scribe v2 (même clé que la voix),
    son envoyé brut en 16 bits / 16 kHz, le format le plus rapide d'après
    ElevenLabs ; en cas de panne réseau, la phrase est ignorée sans planter.
    - --ecoute whisper : Whisper sur le PC, en recherche simple (beam 1, sans
    second découpage) : 2,2 s → 1,7 s sur l'enregistrement de test, même
    phrase comprise ; la caméra suspend ses calculs pendant la transcription.
    Scribe testé avec un faux client (format, modèle, langue, panne) ; pas
    encore avec la vraie clé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
2026-11-11 Tête : conversation en flux continu (transcription et voix en direct)
    Nicolas veut se rapprocher du temps réel ; il a choisi de garder Claude,
    la caméra, la mémoire et la voix v4, et de supprimer les attentes entre
    les étapes (voie A).
    - OreilleTempsReel : ElevenLabs Scribe v2 temps réel. Le son part pendant
    qu'on parle, le serveur repère la fin de phrase (0,5 s) ; rien n'est
    envoyé pendant que Câlin parle ; reconnexion si le serveur ferme.
    - Voix en direct : le texte de Claude est transmis mot par mot à
    ElevenLabs (stream-input), son joué après 0,3 s de réserve.
    - Replis : transcription phrase par phrase puis Whisper ; voix phrase
    par phrase si le modèle refuse l'envo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
2026-11-11 Tête : mesurer le vrai premier son, et dire quelle voix a servi
    Les temps envoyés par Nicolas (1re phrase à 2,2 s, réponse complète
    19,5 s) étaient trompeurs : en mode direct, la mesure partait au premier
    mot transmis à ElevenLabs, pas au premier son entendu, et le total
    comprend tout le temps de parole.
    La ligne de temps donne désormais « 1er son entendu » (moment où le son
    sort vraiment du haut-parleur), « fin de la parole », et le mode de voix
    utilisé (direct, phrases, ou phrases après un repli).
    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
2026-11-11 Tête : la voix de Câlin choisie par Nicolas (QynjFzqBt96iEuetB1Tq)
    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
2026-11-11 Tête : afficher au démarrage la version, le dossier du programme et la voix utilisée
    Nicolas entend encore l'ancienne voix alors que son fichier de clés n'en
    choisit aucune : probablement une ancienne copie du programme lancée
    depuis un autre dossier. Le démarrage affiche désormais la version, le
    dossier d'où le programme tourne, la voix et l'origine de ce choix.
    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
2026-11-11 Tête : Câlin restait bloqué après « Bonjour » (fil de la voix jamais démarré)
    Chez Nicolas, Câlin affichait son message de bienvenue puis ne faisait
    plus rien. Cause : dans la modification « mesurer le vrai premier son »,
    le démarrage du fil qui fait parler Câlin s'est retrouvé dans une autre
    fonction ; la file des phrases n'était jamais lue et le programme
    attendait sans fin. Les essais faits alors tournaient sans voix (--muet)
    ou en mode direct, qui n'utilise pas ce fil : ils ne l'ont pas vu.
    Corrigé, et ajout de diagnostics :
    - voix qui ne répond pas depuis 12 s : message ; micro rendu de force à 42 s ;
    - écoute en direct : texte entendu affiché en direct, « écoute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
2026-11-11 Tête : premier son plus tôt (premier morceau dès la virgule, réserve 0,4 s)
    Mesures de Nicolas : 5 à 7 s avant le premier son, dont 2,5 s entre le
    premier mot de Claude et le son ; la voix en direct n'a pas servi
    (« voix : phrases »).
    - Le premier morceau de chaque réponse part à la voix dès la première
    virgule (après 20 caractères), sans attendre la fin de la phrase.
    - Réserve avant de jouer le son : 0,8 → 0,4 s.
    Découpage vérifié sur trois réponses types ; le texte gardé dans
    l'historique est inchangé.
    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
2026-11-11 Tête : réponses plus courtes, et plus de fausse alerte sur la voix
    Essai de Nicolas avec Ambre et Eliott : jusqu'à 2,8 s avant la voix au
    meilleur, mais des réponses de 15 à 20 s de parole, et l'alerte « la voix
    ne répond pas depuis 12 s » pendant que Câlin parlait encore.
    - L'alerte ne part que si aucun son n'est sorti au bout de 12 s ; une
    longue réponse en cours n'est plus prise pour une panne.
    - Consigne : une ou deux phrases courtes (moins de 30 mots), plus de
    détails seulement sur demande ; avec une photo, répondre à la question
    en une phrase au lieu de décrire tout le décor.
    Alerte vérifiée avec une voix qui parle longtemps (pas d'alerte) et une
    voix muette (a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
2026-11-11 Feuille de route : objectif « Câlin sert le café », avec ses règles de sécurité
    Nicolas veut que Câlin puisse servir le café. Possible avec un bras de
    table, à condition de ne pas tendre une boisson brûlante : gobelet
    couvert posé sur la table devant la personne, trajet lent et bas, force
    limitée, arrêt si une main approche, machine déclenchée par l'ESP32,
    boissons froides pour les enfants au club. Essais d'abord à vide.
    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
2026-11-11 Pince V1 : mâchoires parallèles à engrenages pour le bras de Câlin
    Choix de Nicolas : pince parallèle, ouverture pour un gobelet moyen.
    Le servo tourne l'engrenage A, l'engrenage B tourne en sens inverse ;
    chaque bras moteur est doublé d'un bras libre parallèle, si bien que les
    doigts restent parallèles. Pivots sur roulements 623ZZ ; la pince
    s'enfile sur le bout de l'avant-bras (fourche V1.2) et se fixe par les
    deux vis de l'entretoise, sans réimprimer la fourche. Partie haute du
    servo évitée (1 mm), bride à cale.
    Vérifié hors impression : mouvement de 6 à 95 mm en 24 positions sans
    aucune collision ; pièces fermées et d'un seul volume ; masse estimée
    125 g avec le servo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
    [pince_base.stl, pince_bras_libre_+Y.stl, pince_bras_libre_-Y.stl, pince_bride.stl, pince_doigt_+Y.stl, pince_doigt_-Y.stl, pince_engrenage_A.stl, pince_engrenage_B.stl]
2026-11-11 Pince V2 : plus large, mâchoires creusées, et vérifiée avec de vrais gobelets
    Nicolas demande si la pince n'est pas trop étroite. Vérification faite
    avec un gobelet de 80 mm entre les mâchoires : en V1, il butait contre
    la base et l'engrenage A ; la marge d'approche n'était que de 7,5 mm par
    côté, et des mâchoires plates tiennent mal un objet rond.
    V2 : bras de 50 mm, ouverture 110 mm, mâchoires de 40 mm plus en avant
    et creusées en arc (rayon 45) pour centrer le gobelet ; fermée à 14 mm
    au creux (4,6 mm entre les bouts). Vérifié hors impression : aucune
    collision sur tout le mouvement ; gobelets de 55, 80 et 90 mm, tenus au
    milieu ou par le haut, ne touchent que les mâcho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
    [pince_bras_libre_+Y.stl, pince_bras_libre_-Y.stl, pince_doigt_+Y.stl, pince_doigt_-Y.stl, pince_engrenage_A.stl, pince_engrenage_B.stl]
2026-11-11 Tête n° 12 : version numérotée, refus de la voix en direct mémorisé, photo de suivi
    Essai de Nicolas avec Aïka et Raphaël le chat (sur une version antérieure).
    - Version affichée numérotée (n° 12) : avec « 11/11/2026 » seulement, on
    ne voyait pas qu'une ancienne copie tournait encore.
    - ElevenLabs refuse la voix en direct avec eleven_v4_turbo (HTTP 400) :
    le refus est noté par modèle dans calin_donnees et n'est plus retenté.
    - « Et là, c'est mieux ? » ne déclenchait pas de photo et Câlin demandait
    de reposer la question : la question qui suit une question visuelle
    reçoit aussi la photo ; mots déclencheurs ajoutés.
    - L'écoute en direct se reconnectait à ch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
2026-11-11 Pince : pièces correctement orientées pour l'impression, bride à dessous plat
    En vérifiant l'impression demandée par Nicolas : les doigts reposaient
    sur le bout de la mâchoire, l'engrenage A sur son patin de 1 mm (dents
    dans le vide) et la bride retournée sur la pointe de son pivot.
    Doigts et engrenage A retournés ; bride redessinée avec un dessous plat,
    les piliers s'arrêtant 0,5 mm sous le servo (serrage au vissage). Chaque
    pièce repose maintenant à plat (42 à 98 % de son empreinte au contact).
    Toujours aucune collision sur tout le mouvement. Conseils d'impression
    des engrenages et d'ajustage des roulements ajoutés au mode d'emploi.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
    [pince_base.stl, pince_bride.stl, pince_doigt_+Y.stl, pince_doigt_-Y.stl, pince_engrenage_A.stl]
2026-11-11 Pince : plan de montage illustré en 8 étapes
    Nicolas demandait un plan de montage : deux planches (étapes 1-4 et 5-8)
    générées depuis le modèle, chaque étape montrant en couleur ce qu'on ajoute,
    avec inserts, roulements et vis dessinés au-dessus de leur trou.
    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
2026-11-11 Pince : lien vers le plan de montage dans le mode d'emploi
    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
2026-11-11 Pince : plan de montage une page par étape, et deux défauts de visserie corrigés
    Nicolas ne s'y retrouvait pas dans les deux planches. Nouveau plan (PDF de 10 pages) :
    page des pièces avec leur nom, puis une page par étape avec étiquettes fléchées,
    « Il te faut » et « Ce qu'il faut faire ».
    En le préparant, deux défauts de la pince :
    - au bout des bras libres, l'écrou sous le doigt tapait dans le bras de l'engrenage
    pince presque fermée : la vis M3 x 10 se visse maintenant dans le bras (trou 2,8) ;
    - M3 x 12 trop courtes pour l'écrou frein du doigt : M3 x 16.
    Passages de tête au-dessus des roulements portés à 6,5 mm (la tête ne touche que la
    bague intérieure). Bras l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
    [pince_bras_libre_+Y.stl, pince_bras_libre_-Y.stl, pince_engrenage_B.stl]
2026-11-11 Pince : simulation de la visserie sur toute la course, vis M3 x 8 au bout des bras libres
    Nicolas demandait si le montage avait été simulé. La vérification ne portait que sur les
    pièces imprimées. Nouveau verifier_visserie.py : vis, écrous et rondelles sur 30 positions.
    Il confirme le défaut corrigé (écrou de l'ancienne V2 contre les engrenages, de 14 à 54 mm
    d'ouverture) et montre qu'une M3 x 10 au bout des bras libres arrivait au ras du bras de
    l'engrenage : M3 x 8 (2 mm de marge), plan et liste de visserie mis à jour.
    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
    [plan_montage.py, verifier_visserie.py]
2026-11-12 Feuille de route : lidar pour la sécurité, tri d'objets, se repérer, bras de taille humaine
    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
2026-11-12 Coude : premier essai réel réussi, plusieurs commandes d'un coup
    Nicolas a tapé « c d g » : refusé, une lettre à la fois seulement. Le menu accepte maintenant
    une série séparée par des espaces (« et » ignoré) ; une lettre inconnue n'en lance aucune,
    un mouvement refusé annule la suite. Essai réel du 12/11 consigné (carte neuve, ancien servo
    intact, ± 30° à 0,2° près, charge ± 2 %).
    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
2026-11-12 Coude validé : ± 90° avec la fourche complète
    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
2026-11-12 Pince : programme d'essai motorisé, serrage à force limitée
    Nicolas monte la pince demain. tester_pince.bat : servo n° 4, butées 1663-2433 vérifiées,
    sens d'ouverture appris au premier lancement, milieu / ouvrir / fermer, et « serrer » qui
    avance avec une force limitée (20 ou 35 %) et s'arrête seul sur l'objet en donnant sa
    largeur. servos.py : limiter_force() (registre 48) et serrer(). Simulé : sans objet et avec
    un gobelet ; pas encore essayé sur la vraie pince.
    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
2026-11-13 Feuille de route : validation de la pince en cours, épaule STS3215 + ressort
    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
2026-11-13 Pince : étalonnage du milieu à la main, engrenage A vissé là où ses trous tombent
    Nicolas n'arrivait pas à avoir 81 mm et les trous de l'engrenage A sur ceux du palonnier :
    ils ne s'alignent que tous les quarts de tour. On visse A où les trous tombent, on règle la
    pince à la main à mi-ouverture, et le servo prend cette position comme milieu (registre 40
    = 128, table mémoire Feetech STS3215). tester_pince le propose au premier lancement, ou si
    le servo est hors butées, ou par la commande e. Plan de montage : étape 6 sans servo branché,
    étape 9 essai de la pince seule avant de l'enfiler sur l'avant-bras. Simulé, pas encore réel.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
2026-11-13 Pince : engrenage A pour les vis courtes fournies avec le servo
    Nicolas : les vis M2,5 fournies avec le servo ne traversent pas l'engrenage A (5 mm de
    plastique sous la tête), et il n'a pas de M2,5 x 8. Variantes à logement de tête plus
    profond pour des vis de 4, 5 ou 6 mm : la vis entre de 2 à 2,5 mm dans le palonnier,
    au moins 2 mm de plastique sous la tête. Aucune collision, pièces fermées.
    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
    [pince_engrenage_A.stl, pince_engrenage_A_vis4mm.stl, pince_engrenage_A_vis5mm.stl, pince_engrenage_A_vis6mm.stl]
2026-11-13 Pince : vue de dessus du montage correct (quel bras dans quel trou du doigt)
    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
    [vue_dessus.py]
2026-11-13 Pince : bout des bras libres serré sur le doigt (roulement dans le bras + bouchon)
    Essai réel de Nicolas : dès que la pince serre, le bras libre sort de son emplacement au
    doigt. La vis vissée dans le bras n'entrait que de 2,5 mm dans le roulement arrière du doigt :
    l'objet appuie sous la mâchoire, le doigt bascule, soulève le bras, la vis sort et la mâchoire
    tourne. Maintenant comme aux pivots : roulement dans le bras (un à chaque bout), la tête de la
    M3 x 8 serre sa bague intérieure sur un bouchon imprimé placé dans le trou arrière du doigt
    (les doigts restent bons). Toujours 7 roulements. Aucune collision, visserie vérifiée sur
    toute la course (1 mm sous la pointe). Plan d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
    [pince_bouchon_doigt.stl, pince_bras_libre_+Y.stl, pince_bras_libre_-Y.stl]
2026-11-14 Pince : variantes à insert M3 x 5 x 4 pour le trou arrière des doigts
    Nicolas a des inserts courts (4 mm de long = épaisseur de la plaque du doigt). Bouchon à
    insert (trou de 4,3, paroi 2,8) pour les doigts actuels, ou doigts avec le trou arrière
    prévu pour l'insert. Filetage en laiton au lieu du plastique ; même vis M3 x 8.
    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
    [pince_bouchon_doigt.stl, pince_bouchon_doigt_insert.stl, pince_doigt_+Y_insert.stl, pince_doigt_-Y_insert.stl]
2026-11-14 Pince V3 : plus de point mort, dents refaites, pince coincée coupée en 1 s (#1)
    Essai réel de la V2 le 14/11/2026 : un doigt s'est retourné pince fermée,
    la pince s'est coincée à la réouverture et les dents ont sauté.
    - Pivots des bras libres déplacés en diagonale sur deux poteaux de la base :
    les bras ne s'alignent plus avec le doigt sur toute la course.
    - Engrenages : fond de dent plat (0,33 mm de place au lieu de 0,03).
    - Poteau de l'engrenage B plus gros, bride simplifiée.
    - servos.py : force coupée si le servo n'avance plus ; seuil de blocage
    adapté à la pince dans test_pince.py.
    - Nouvelles vérifications : retournement du doigt (retrouve le défaut de la
    V2), den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
    [pince_base.stl, pince_bride.stl, pince_doigt_+Y.stl, pince_doigt_+Y_insert.stl, pince_doigt_-Y.stl, pince_doigt_-Y_insert.stl, pince_engrenage_A.stl, pince_engrenage_A_vis4mm.stl]
2026-11-14 Pince V3 : bras libres élargis à 15 mm (#2)
    À 12 mm de large, il ne restait que 0,95 mm de plastique autour du
    roulement 623 : il a fendu la paroi en entrant (retour d'impression).
    15 mm donne 2,45 mm. generer_pince.py refuse maintenant toute paroi de
    moins de 1,8 mm autour d'un roulement. Les 7 vérifications passent.
    Claude-Session: https://claude.ai/code/session_011MQ11mkr6oZP4ZybnZ7TYm
    [pince_bras_libre_+Y.stl, pince_bras_libre_-Y.stl]
